ravikola02/egoumi/README.md

# EgoUMI: UMI pinch gripper + ArUco head-camera tracking

A non-powered, UMI-style handheld gripper that you close with a thumb + index pinch, tracked with ArUco markers
from an egocentric **head** camera, so that human demonstrations can become robot-learning datasets.

It builds on my [**h2r_collection**](https://github.com/ravikola02/h2r_collection) pipeline (egocentric head video →
HaWoR hand pose + head SLAM → LeRobot dataset). The goal is a `--source gripper` mode there that replaces the
HaWoR hand pose with the gripper pose from the markers and keeps HaWoR's head-camera SLAM
([plan](docs/h2r_gripper_plan.md)).

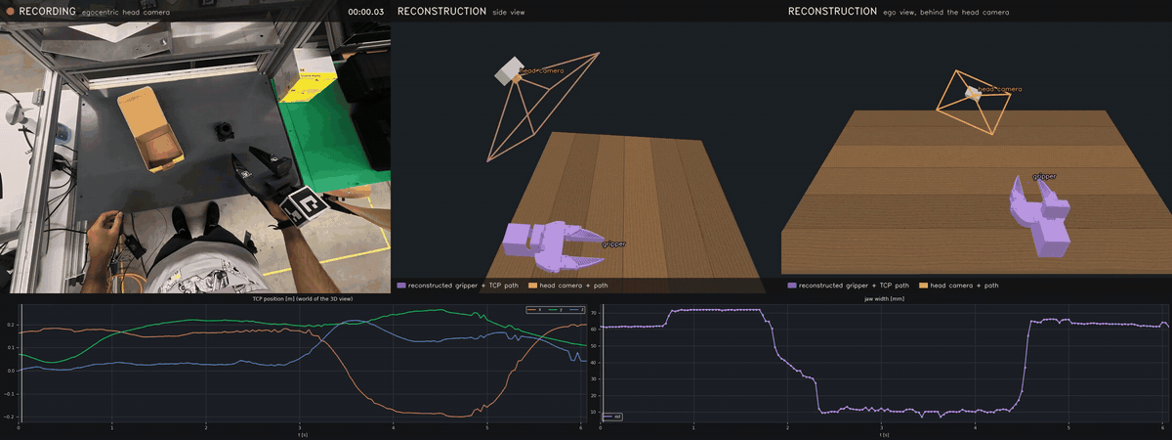
[picture p1: assets/preview_real.gif]
Real capture: egocentric head recording, side view and ego view of the reconstructed gripper and head camera


*Real capture, pick-and-place episode ([mp4](assets/preview_real.mp4)). **Left, RECORDING:** the egocentric head
camera (DJI Osmo Nano, 4:3). **Middle, side view / right, ego view (chase camera behind the head):** the gripper pose
from the ArUco markers (purple, with its TCP path) and the head camera from masked DROID-SLAM (orange, with its path).
Bottom: gripper TCP position (x, y, z) and the jaw width from
the gripper camera. No ground truth here; the 3D views are levelled with the gripper's own up axis and the table plane
is placed approximately (display only).*

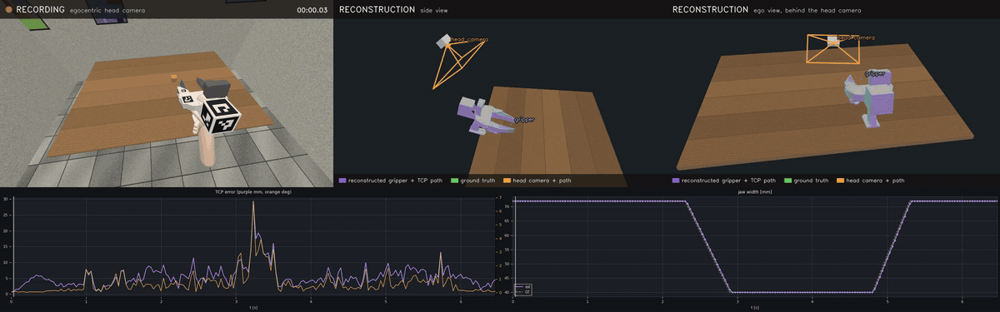
[picture p2: assets/preview_pick_place.gif]
Simulated capture: head recording, side view and ego view with ground truth, TCP error and jaw width


*Simulated pick-and-place through the same pipeline ([mp4](assets/preview_pick_place.mp4)): a rendered 3-camera
capture, ArUco pose from the head camera, head motion from masked DROID-SLAM, jaw width from the gripper camera.
Estimate in purple, ground truth in green. TCP error median 5.0 mm / p90 8.9 mm (SLAM included), jaw width within
0.9 mm. Debug style, which overlays the estimate on the frame with per-tag detail:
[wrist-roll episode](assets/preview_roll.mp4) (4.4 / 7.2 mm).
Made with `scripts/episode_preview.py` + `scripts/preview_gripper.py --style presentation --ego`.*

## What's here
| Part | Status |
|---|---|
| `cad/`: gripper derived from the [Stanford UMI](https://umi-gripper.github.io/) CAD; pistol grip kept, trigger replaced by a thumb ring and an index ring on the finger holders; mirrors removed to make room for tags | CAD done and collision-checked, print files for a Bambu H2D in `cad/out_v3` ([print notes](docs/PRINT_NOTES.md)); printed and used for real captures |
| `sim/`: synthetic head-camera episodes (textured CAD, ArUco stickers, hand stand-in, wood-grain table, object, head bob, tremor, blur, noise) in HaWoR's frame layout, with ground truth | working |
| `umi_pipe/` + `scripts/gripper_pose.py`: subpixel ArUco → multi-tag PnP (SQPNP + LM, outlier rejection, single-tag disambiguation) → joint body + jaw refinement → jaw width → world TCP pose | working in sim and on real captures (body pose found in every frame of the real episode above, 2–3 px reprojection most of the time) |
| `scripts/preview_gripper.py` (+ `scripts/episode_preview.py` for a collection episode): the previews above, the gripper counterpart of HaWoR's MANO cam/world visualisation; side view, `--ego` chase view; runs on real episodes without ground truth | working |
| `collection/`: 3-camera capture (head + 2 gripper/wrist cams) → audio sync → browser tagger → frame-exact clips → LeRobot v3.0 / v2.1, the h2r_collection flow without HaWoR ([details](collection/README.md)) | working: tested on the h2r_collection Sample session, a rendered capture and a real gripper capture (11 pick-and-place episodes; wrist offset found from audio at confidence 103; no left wrist camera) |
| Trajectories in the dataset: `--state-source aruco` reconstructs the gripper TCP from the head clips (14-d h2r_collection layout); with sim ground truth the same dataset also gets `observation.state_gt` / `action_gt` | working in sim and on real captures: gripper value from the gripper (wrist) camera; causal EMA α 0.18 on the predicted pose, position and orientation (chosen by the h2r delta-noise criterion, `sim/ema_sweep.py`); head-camera motion from masked DROID-SLAM with Metric3D scale. Real capture: the mount-based jaw fit needs a calibrated gripper-camera mount and lens, so the gripper value there comes from `scripts/gripper_minmax.py` (jaw-tag image position normalised between the most open and most closed seen; a full open/close at the start of each session will set the range) |
| `sim/render_capture.py`: rendered raw capture (head camera, gripper GoPro, blank second wrist feed, skewed clocks, clap soundtrack) + `sim/check_capture_sync.py` (sync and cut accuracy against ground truth) | working |

## Known limitations
- No camera calibration yet: the Osmo Nano intrinsics are the nominal 600 px pinhole (no lens distortion), so real
  poses carry an unmeasured bias, larger near the image edges.
- The gripper-camera mount is nominal; on real captures the gripper value is the min/max-normalised jaw signal
  (`scripts/gripper_minmax.py`), monotonic but not linear in millimetres. Open and close fully at the start of each
  session to set its range.
- The dataset world is the first head-camera frame (as h2r_collection), not gravity-aligned.

## Recording
Cameras are DJI Osmo Nanos, as in h2r_collection (head + one on the gripper). Settings, mounts and the per-session
checklist (4K head, stabilization off, landscape locked, a clap at the start of every take):
[docs/recording_setup_osmo_nano.md](docs/recording_setup_osmo_nano.md).

## Printing the markers
[`assets/print/egoumi_aruco_markers.pdf`](assets/print/egoumi_aruco_markers.pdf) holds all eight markers the pipeline
uses (DICT_4X4_50, IDs 0–7) at exact size on one A4 page, with a back page that, printed double-sided, puts each
marker's placement (part, face and which edge is the top) directly behind it. Print at **100 % / Actual size**,
**double-sided, flip on the long edge**, check the 100 mm bar, and cut along the dashed lines without trimming the
white border. It is generated from `configs/gripper_markers.yaml`:
`python3 scripts/make_marker_sheet.py` (add `--flip short` if your printer flips on the short edge).

| IDs | Where | Marker | Cut size |
|---|---|---|---|
| 0–3 | cube: rear, top, left, right faces | 60 mm | 70 mm (whole face) |
| 4, 5 | top cover: left and right wings (where the mirrors were) | 35 mm | 45 mm |
| 6, 7 | finger holders: top pads (left = thumb, right = index) | 18 mm | 20 mm |

## Quick start: capture → LeRobot dataset
```bash
python3 collection/run_pipeline.py --session <session>   # data/raw/<session>/{top_cam,left_w_cam,right_w_cam}/
```
See [collection/README.md](collection/README.md).

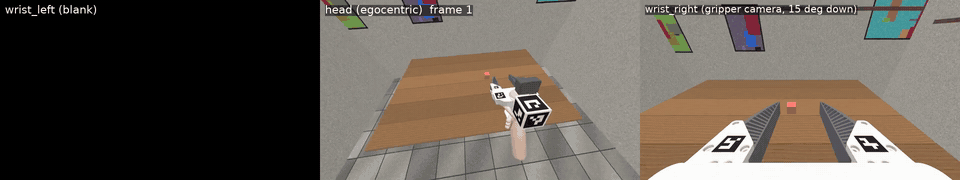
[picture p3: assets/dataset_sim_capture.gif]
LeRobot dataset built from a rendered capture: blank left wrist, head camera, gripper GoPro


*A LeRobot v3.0 dataset made by the pipeline from a rendered capture ([mp4](assets/dataset_sim_capture.mp4)): blank
left wrist feed | head camera | GoPro on the gripper. The three recordings started at different times with skewed
clocks; the audio sync recovered the offsets exactly and every cut is frame-exact against ground truth.*

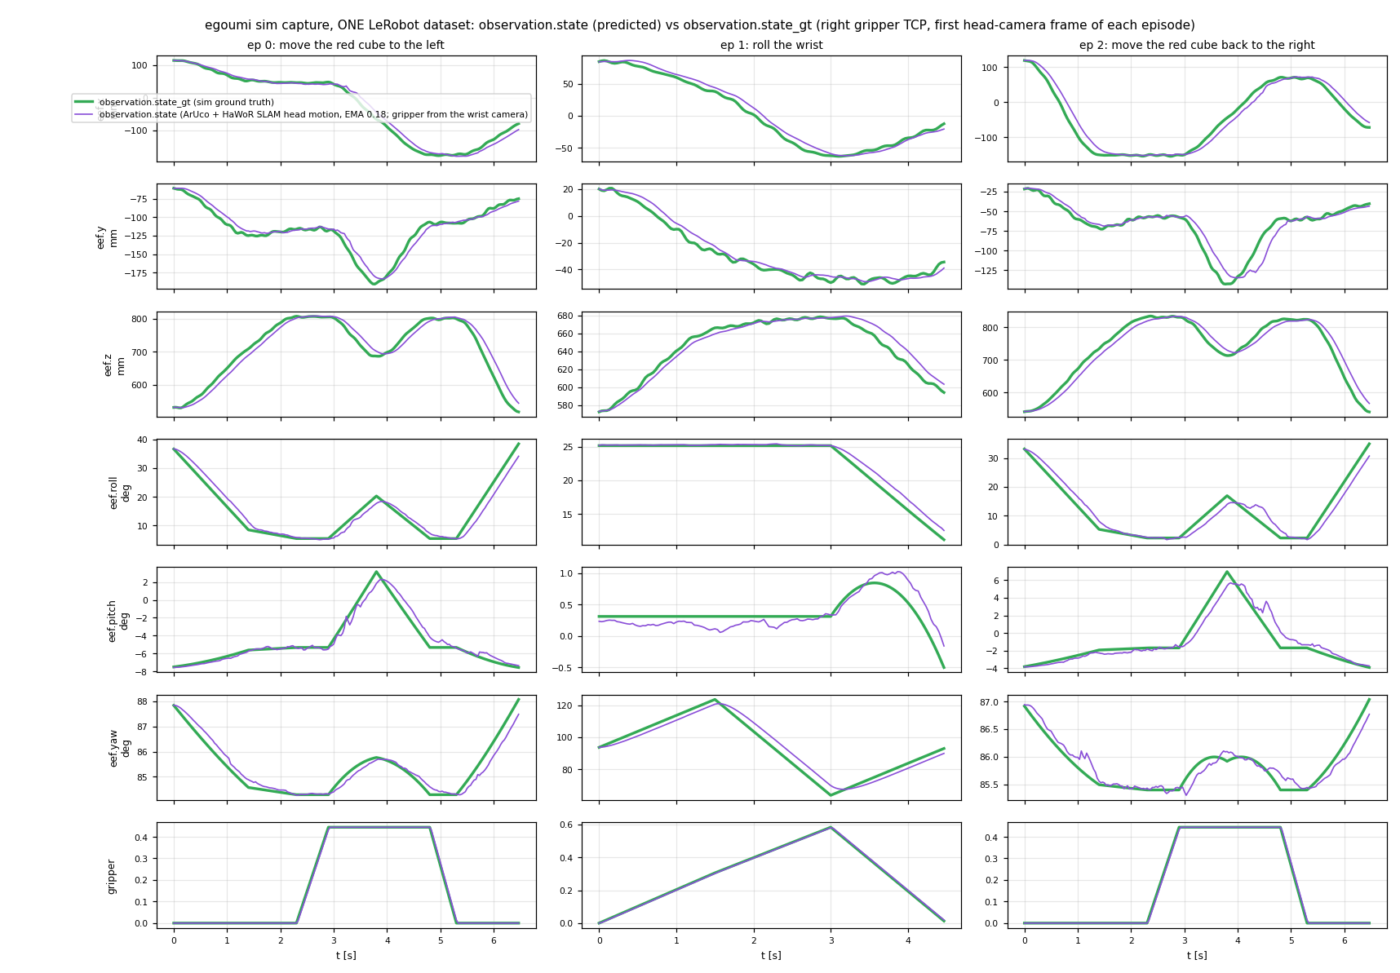
[picture p4: assets/dataset_trajectories.png]
observation.state (ArUco pipeline) vs observation.state_gt (ground truth) from that dataset


*The same dataset's trajectory columns: `observation.state` reconstructed by the full pipeline (purple) against the
raw `observation.state_gt` (green), right gripper TCP in each episode's first head-camera frame. The gripper pose
comes from the ArUco markers and the head-camera motion from masked DROID-SLAM (Metric3D scale); the
gripper value comes from the wrist camera (within about 1 mm of jaw width). Before the EMA the TCP error is
3.3–5.3 mm median. The pose carries a causal EMA (α 0.18 on position and on orientation, 152 ms lag), which brings
the one-step delta noise to the G1 robot's level; the lag is what separates the purple and green position curves
(`--ema-pos 1` turns it off).*

## Quick start (simulation)
Runs in a Python env with `pyrender`, `trimesh`, `opencv-python` (≥ 4.7, ArUco), `scipy`, `pyyaml` and
`matplotlib` (the HaWoR env from h2r_collection has all of them), with headless EGL rendering and `ffmpeg`.
```bash
sim/run_sim_test.sh pick_place                                            # render -> pose -> preview
MARKERS=configs/gripper_markers_jawflags.yaml sim/run_sim_test.sh pick_place_jawflags
sim/run_sim_test.sh roll --preset roll --seed 1
sim/run_sim_test.sh blur_table --blur 5 -- --cam-source table              # args after -- go to gripper_pose.py
# output: sim/episodes/<name>/preview/{gripper_preview.mp4,metrics.json,timeline.png}
```
Set `PY=/path/to/python` if your interpreter is not the HaWoR conda env. `sim/assets/meshes` is checked in;
`sim/export_meshes.py` regenerates it from the STEP file (needs CadQuery).

## Sim results
Egocentric head camera (behind and above the user's hands) with the h2r_collection DJI Osmo Nano intrinsics at
1080p (600 px focal); gripper and markers as in the CAD. A 4K head (recommended) doubles the marker size in pixels.

| Episode | TCP error median / p90 / max | Jaw width seen by the head camera |
|---|---|---|
| pick-and-place | 2.7 / 6.1 / 15.0 mm | 10 % of frames (width error median 0.20, max 0.66 mm) |
| wrist roll | 1.6 / 2.6 / 5.1 mm | 8 % (median 0.23, max 0.48 mm) |

Jaw width comes from the **gripper (wrist) camera**, as in UMI. In the render it sits at the GoPro lens, pitched
down 15° so both jaw tags stay in its pinhole frame over the full travel; it sees both tags at every travel.

What the sim showed so far (details in [sim/README.md](sim/README.md)):
- From the head camera the GoPro and the cube often block the holder-top jaw tags; the wrist camera always sees
  them. An earlier claim here, that they were never visible, came from two renderer bugs (sheared jaw-tag
  textures; stickers lit only by ambient light), both fixed.
- Frames where only one body tag is visible cause most of the head-camera pose error: the TCP is about 29 cm from
  the cube tags.
- Head-camera motion comes from masked DROID-SLAM with Metric3D scale, with the
  gripper and hand masked at their ArUco pose. On the rendered capture it tracks the head within 2–4 mm and
  0.03–0.05° (median); Metric3D's scale is 8–22 % off, the largest remaining term. In a plain-coloured room it
  failed (scale 3.9× off, 13 mm/frame jitter): it needs scene texture, which real rooms have.
- There is no table marker: like h2r_collection, the world frame is each episode's first head-camera frame.

Not modelled yet: lens distortion, rolling shutter, glare. The TCP point is an estimate from the CAD.

## Layout
```
cad/            CadQuery build scripts (v1 → v3), Stanford UMI input STEP, v3 print files, renders
collection/     capture → LeRobot pipeline (sync, tagger, converter)
configs/        marker layouts (body frame = CAD assembly frame, metres), sim camera
docs/           pipeline plan for h2r_collection, print notes
sim/            episode + raw-capture renderers, sync/cut checker, mesh export, one-command test runner
umi_pipe/       shared model / rendering / pose-estimation code
scripts/        gripper_pose.py (pipeline), preview_gripper.py (preview)
assets/         README media
```

## Credits and licence
- The gripper design is adapted from Stanford's [Universal Manipulation Interface (UMI)](https://umi-gripper.github.io/)
  (Chi et al., RSS 2024): its CAD, mechanism and soft fingers are kept, the trigger is replaced by a thumb + index
  pinch, and the side mirrors are removed to make room for ArUco markers. The files in `cad/input/` are their
  design exported from Onshape; their terms apply to that design.
- Data pipeline: [h2r_collection](https://github.com/ravikola02/h2r_collection); `collection/` vendors its sync,
  tagger and dataset writers.
- Head-camera SLAM: the masked DROID-SLAM + Metric3D-scale approach comes from
  [HaWoR](https://github.com/ThunderVVV/HaWoR) (CC BY-NC-ND), and `collection/head_slam.py` runs HaWoR's own SLAM
  wrapper (`hawor_slam`, unmodified) from a local HaWoR checkout; HaWoR is not redistributed here.
  [DROID-SLAM](https://github.com/princeton-vl/DROID-SLAM) (BSD-3), [Metric3D](https://github.com/YvanYin/Metric3D) (BSD-2).
- The code in this repository is MIT licensed (see `LICENSE`).
