ravikola02/egoumi/assets/timeline_pick_place.png

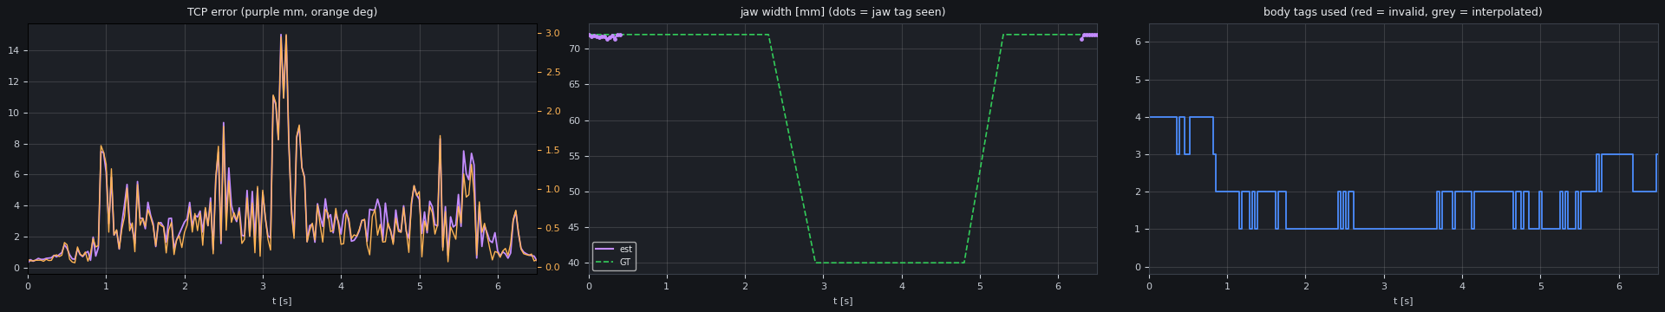
assets/timeline_pick_place.png
