ravikola02/egoumi/cad/renders/orig_full.png

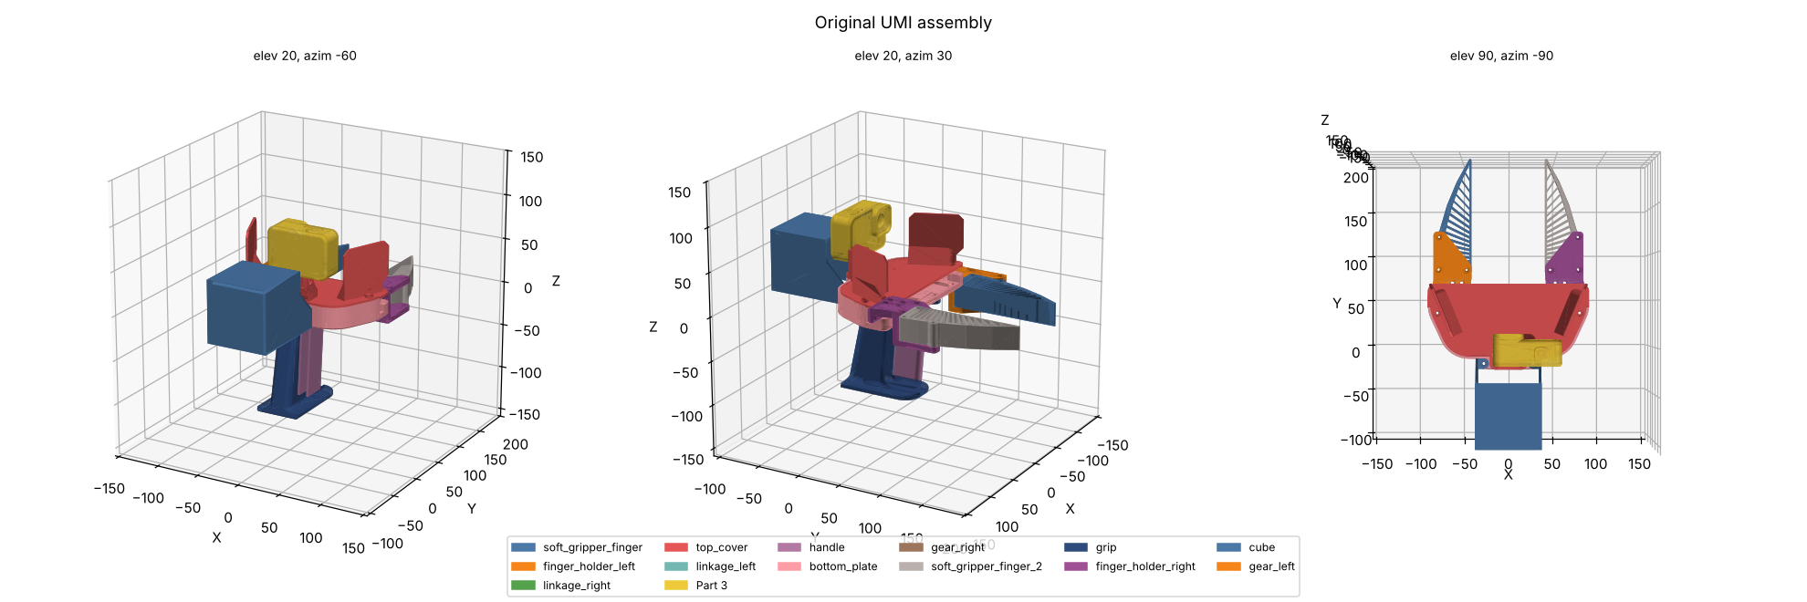
cad/renders/orig_full.png
