ravikola02/egoumi/cad/renders/orig_gears.png

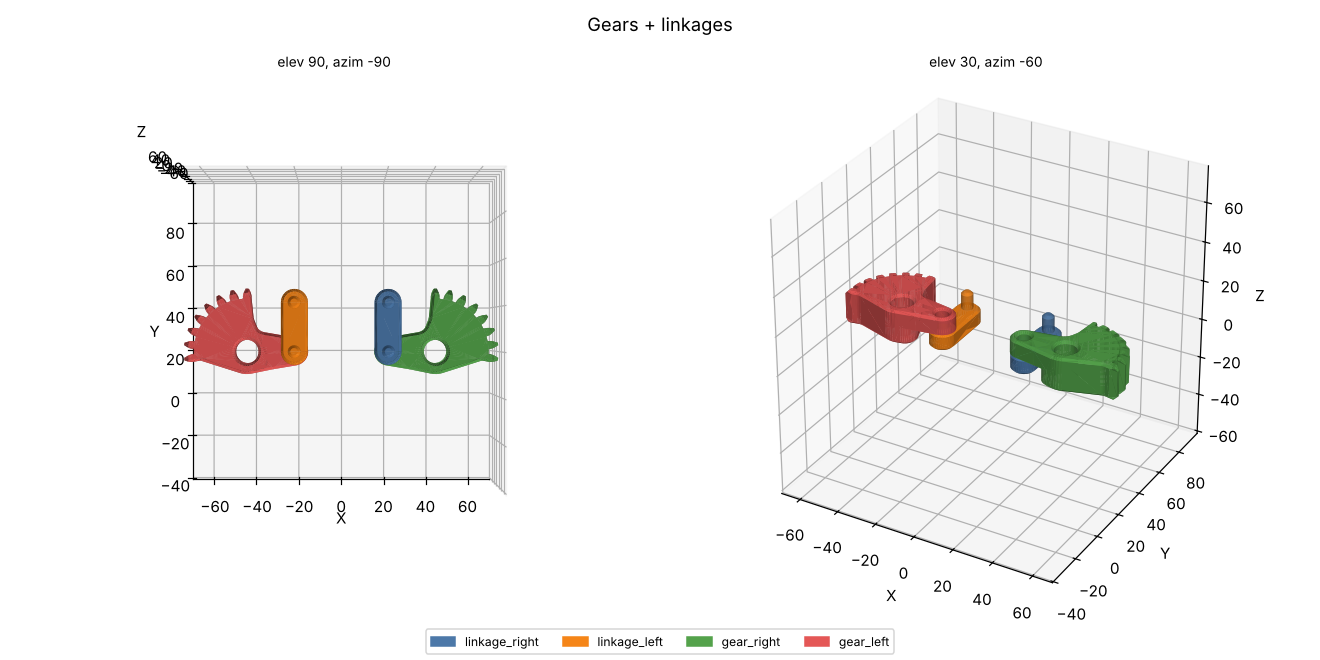
cad/renders/orig_gears.png
