ravikola02/egoumi/cad/renders/orig_handle_grip.png

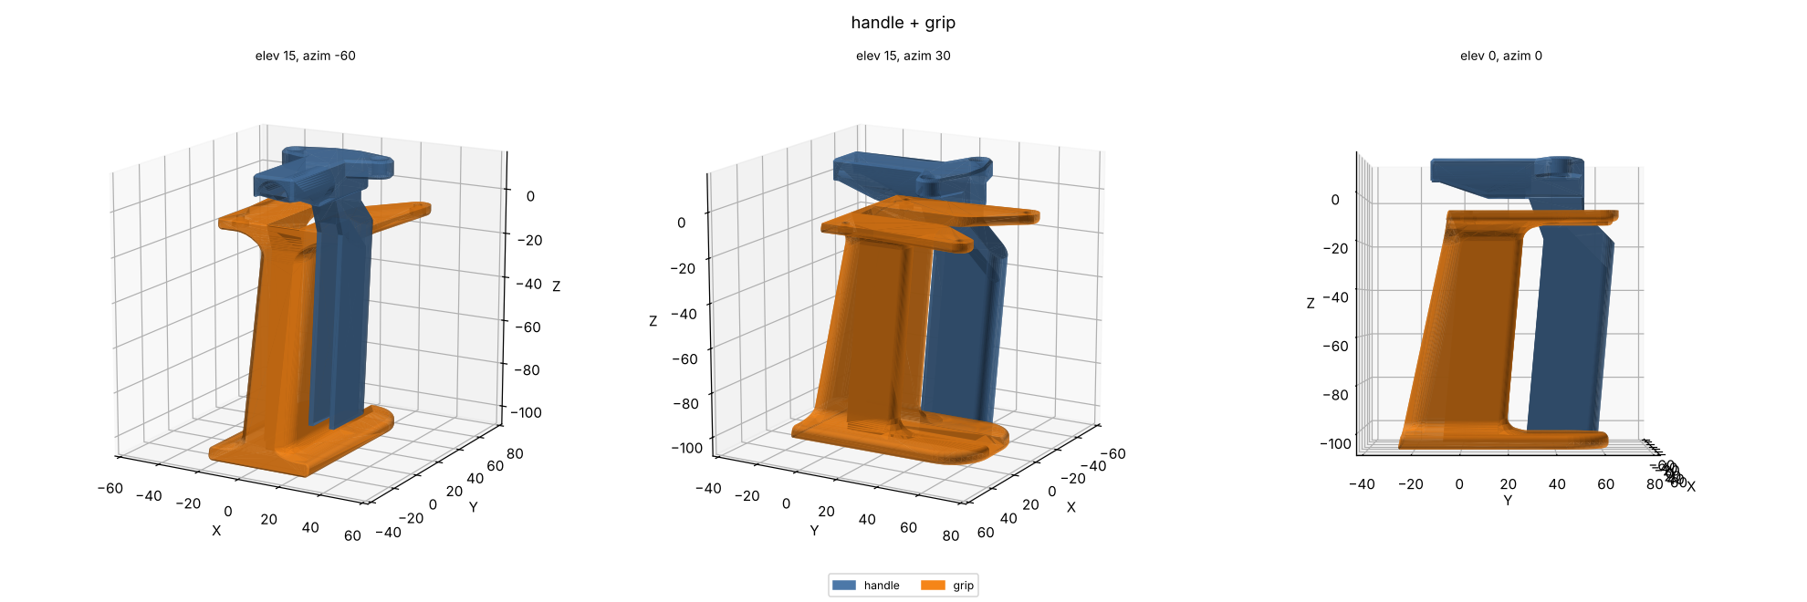
cad/renders/orig_handle_grip.png
