ravikola02/egoumi/cad/renders/orig_mech.png

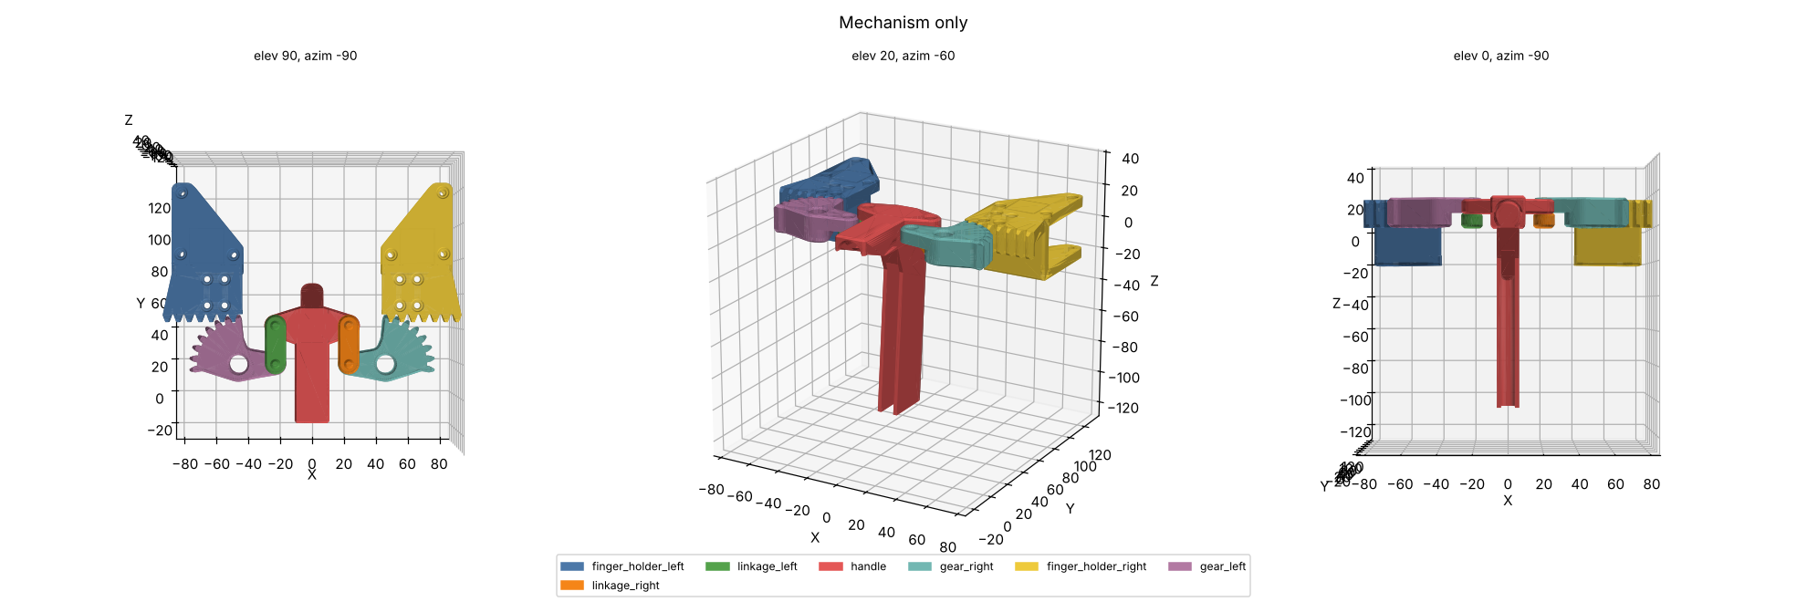
cad/renders/orig_mech.png
