ravikola02/egoumi/cad/renders/orig_section_x0.png

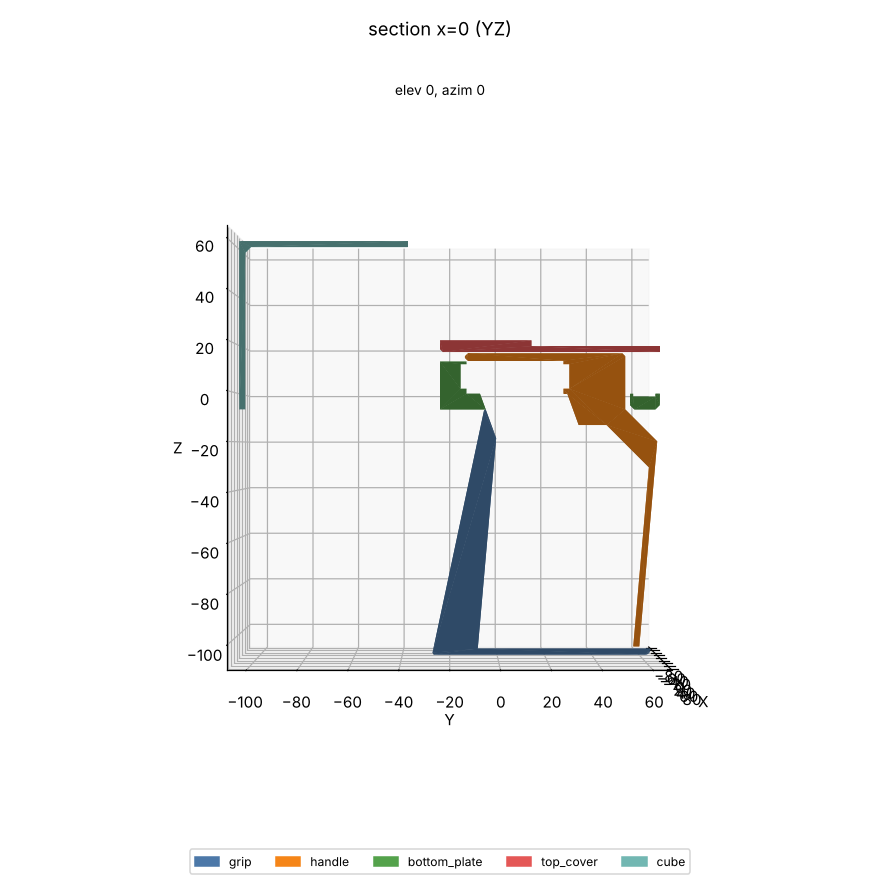
cad/renders/orig_section_x0.png
