ravikola02/egoumi/cad/renders/probe_finger_holder_left_thumb.png

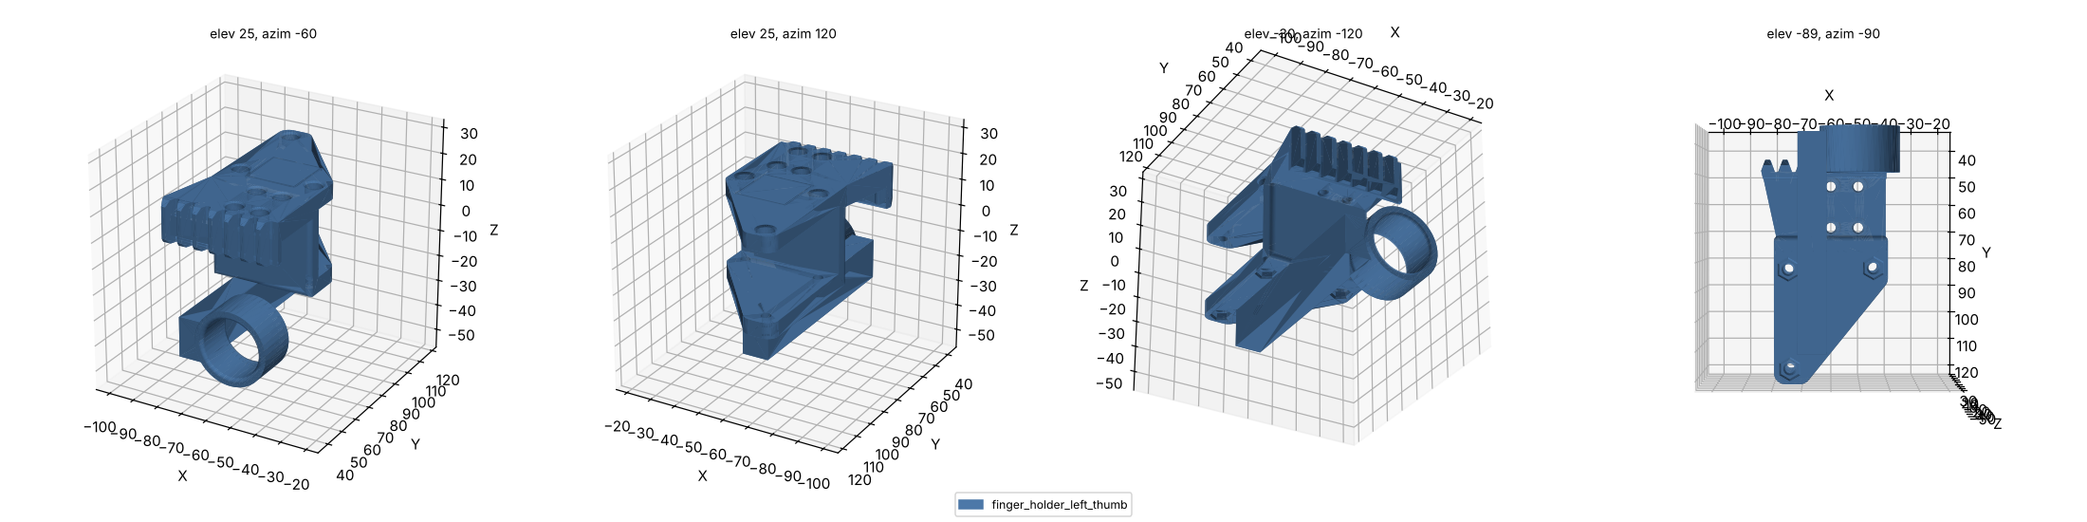
cad/renders/probe_finger_holder_left_thumb.png
