ravikola02/egoumi/cad/renders/probe_holder_bottom.png

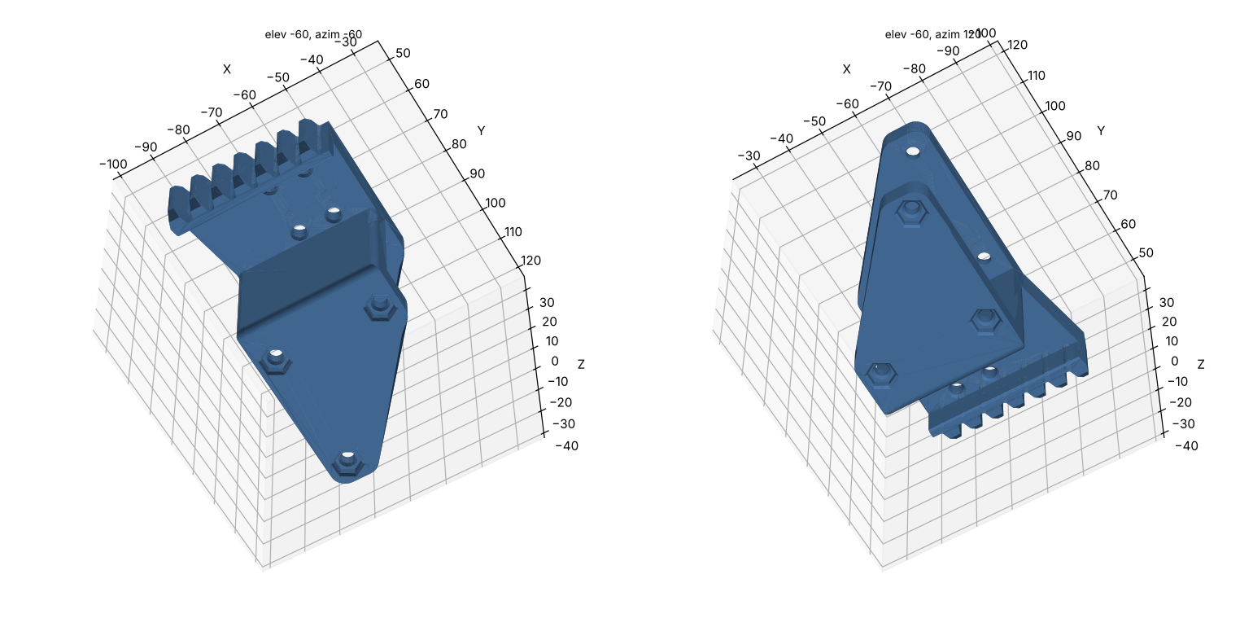
cad/renders/probe_holder_bottom.png
