ravikola02/egoumi/cad/renders/probe_holder_top.png

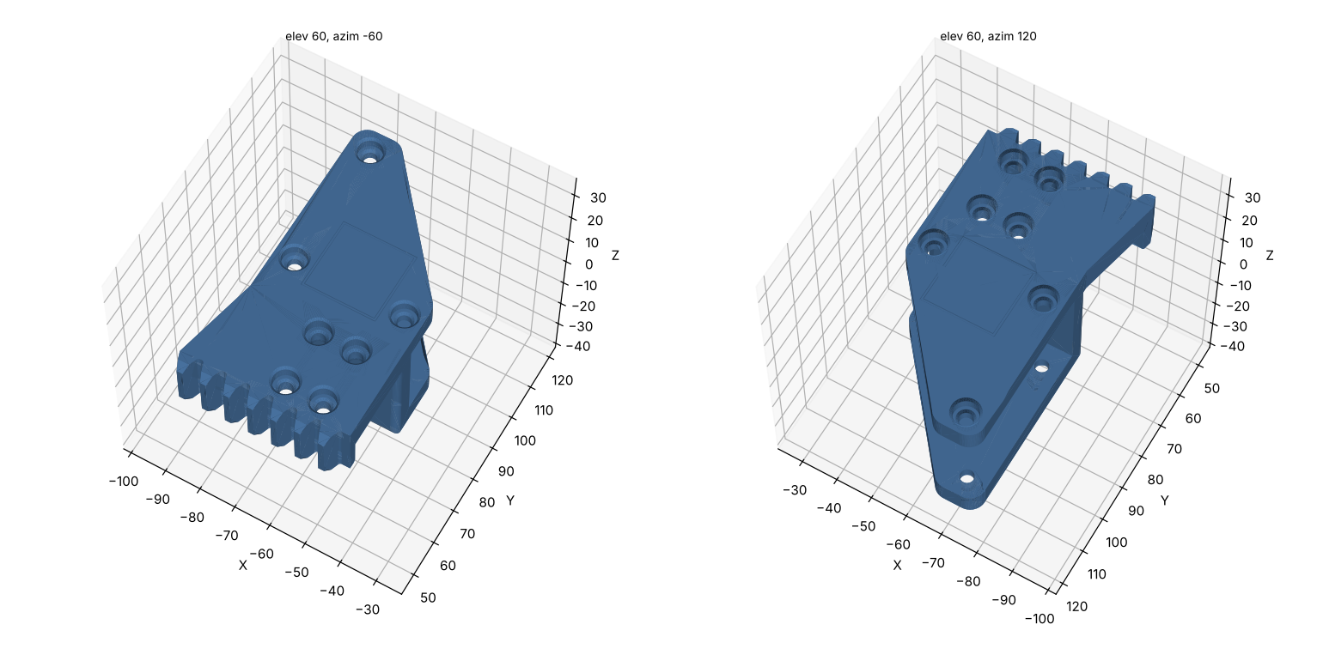
cad/renders/probe_holder_top.png
