ravikola02/egoumi/cad/renders/probe_topcover.png

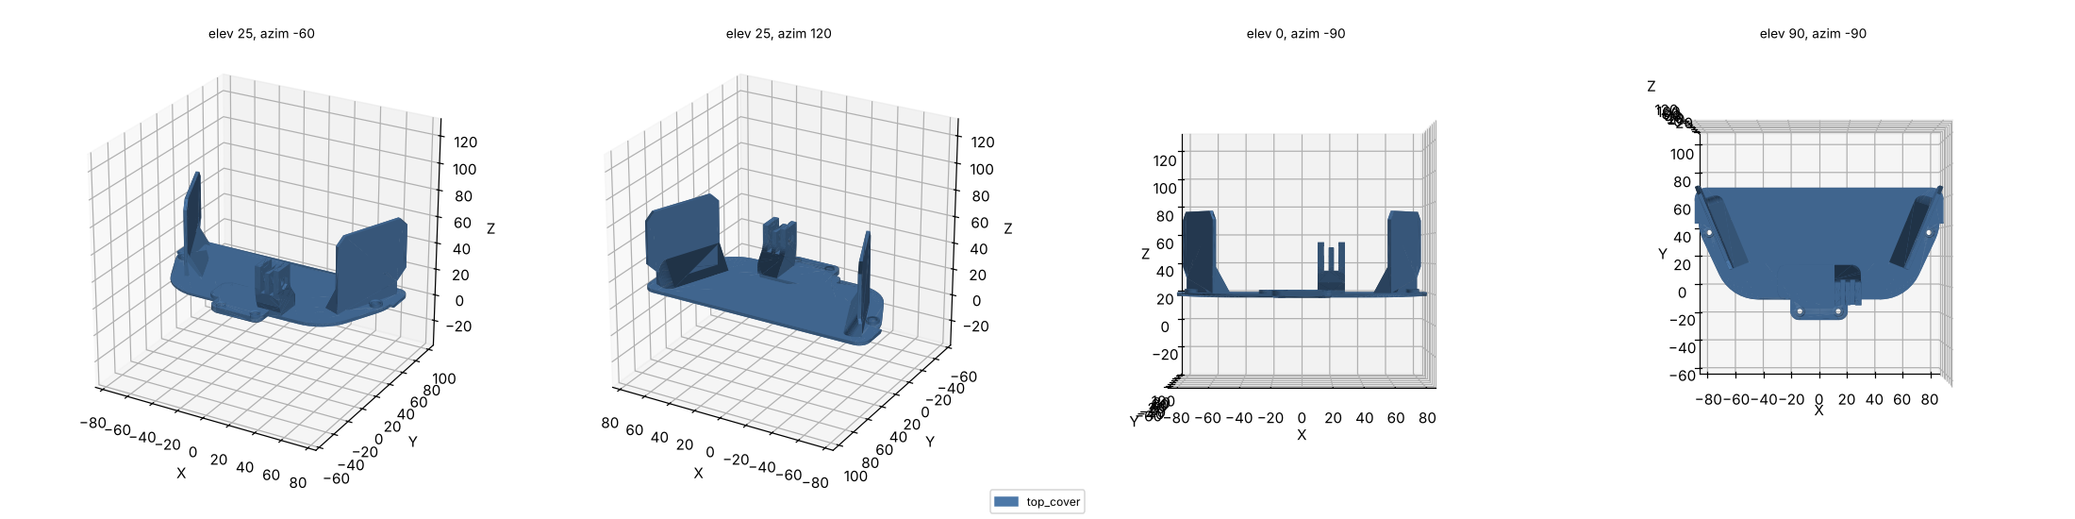
cad/renders/probe_topcover.png
