ravikola02/egoumi/cad/renders/v1_closed.png

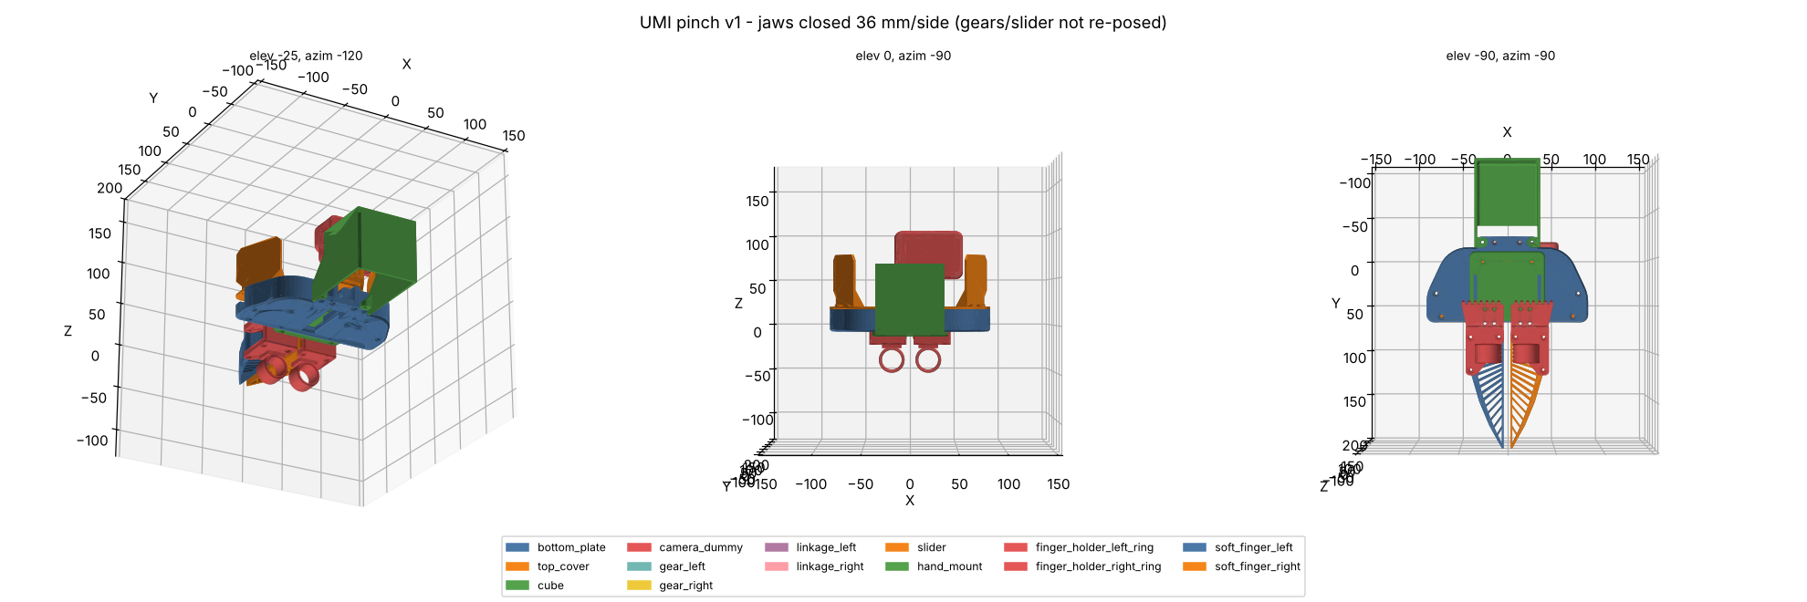
cad/renders/v1_closed.png
