ravikola02/egoumi/cad/renders/v1_newparts.png

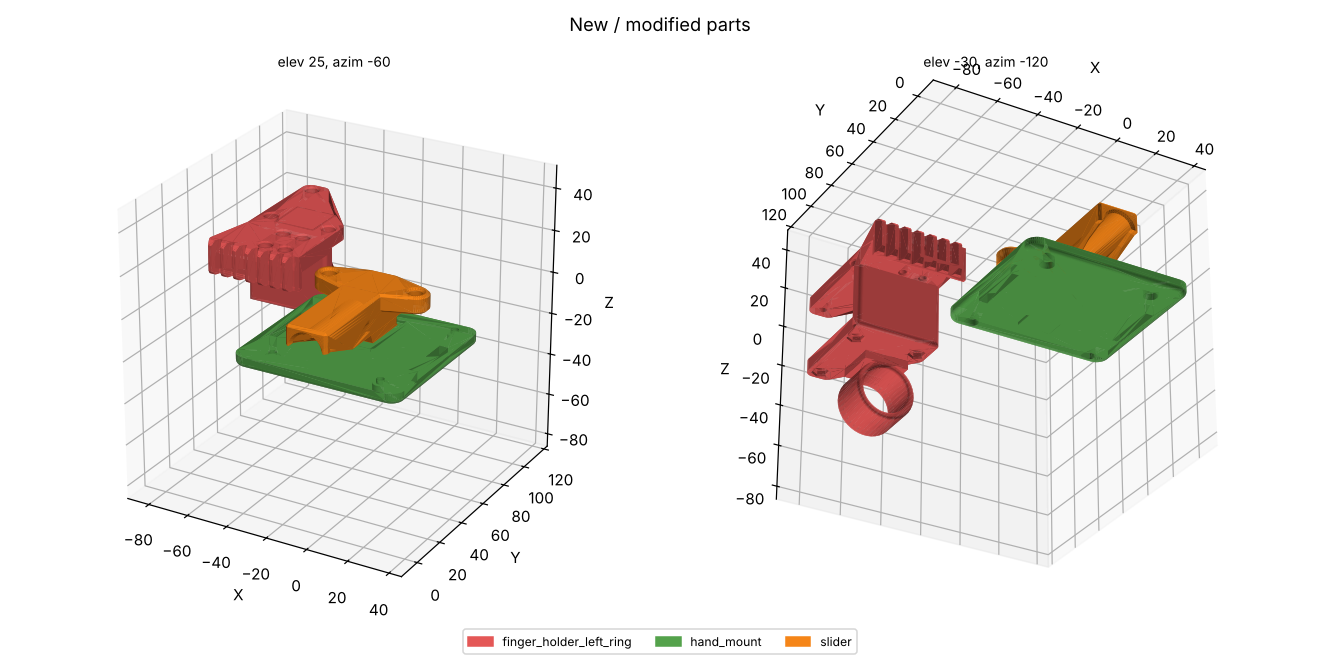
cad/renders/v1_newparts.png
