ravikola02/egoumi/cad/renders/v1_open.png

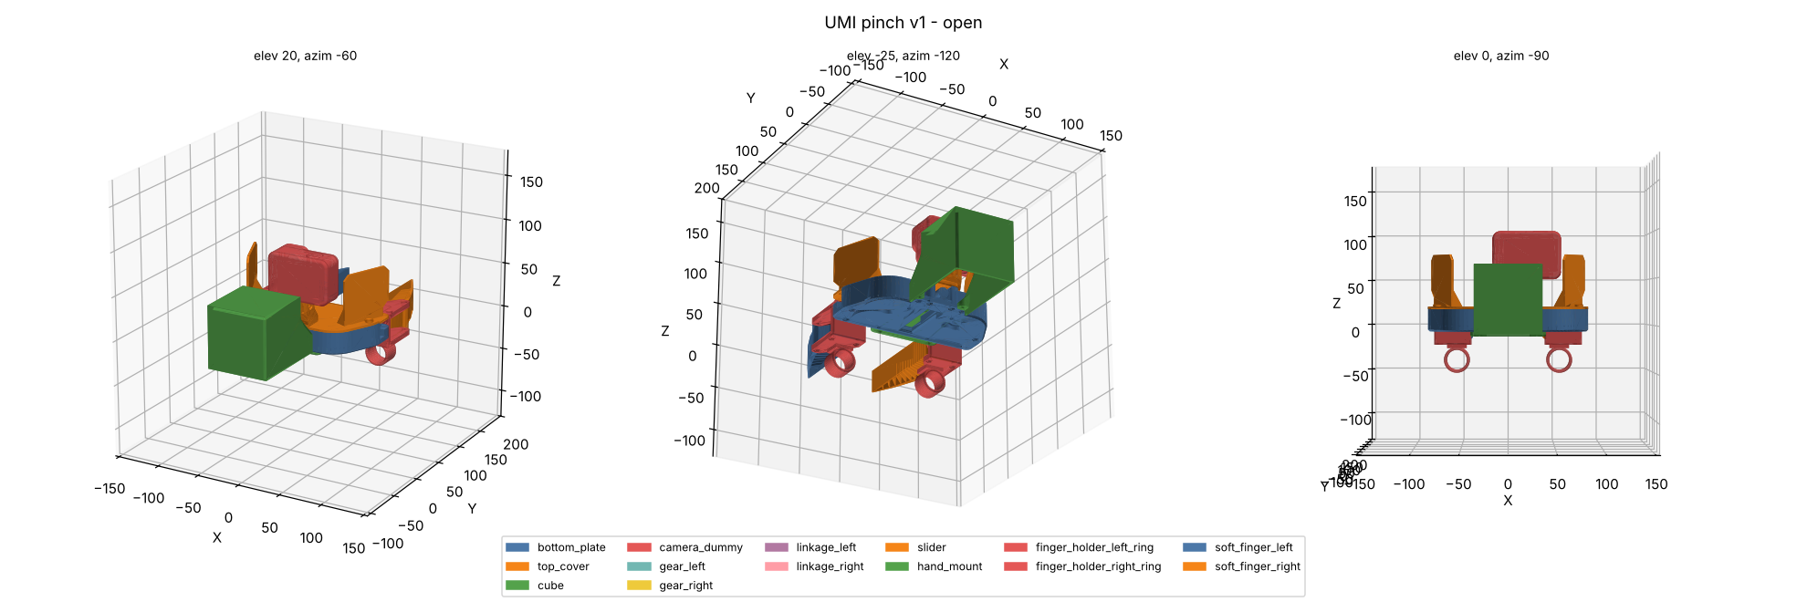
cad/renders/v1_open.png
