ravikola02/egoumi/cad/renders/v2_closed.png

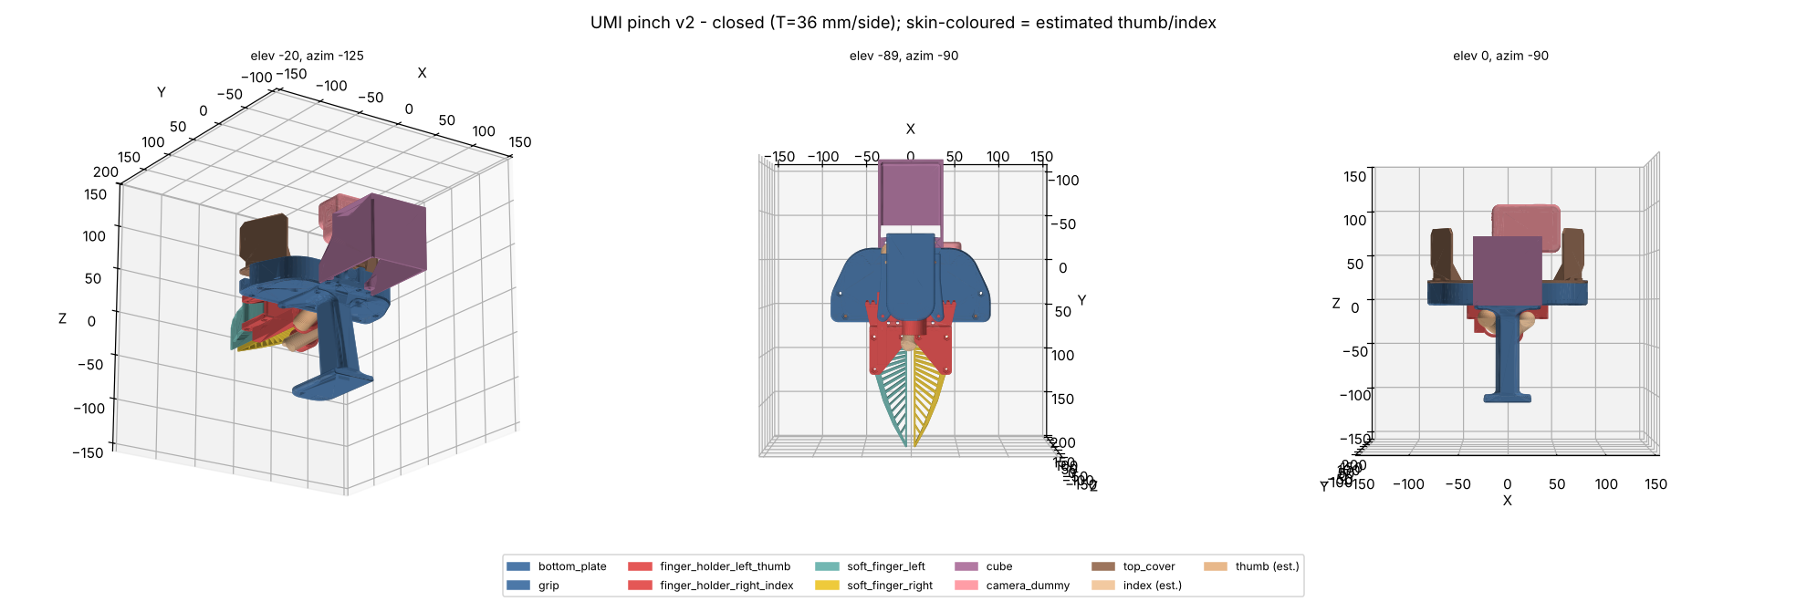
cad/renders/v2_closed.png
