ravikola02/egoumi/cad/renders/v2_rings.png

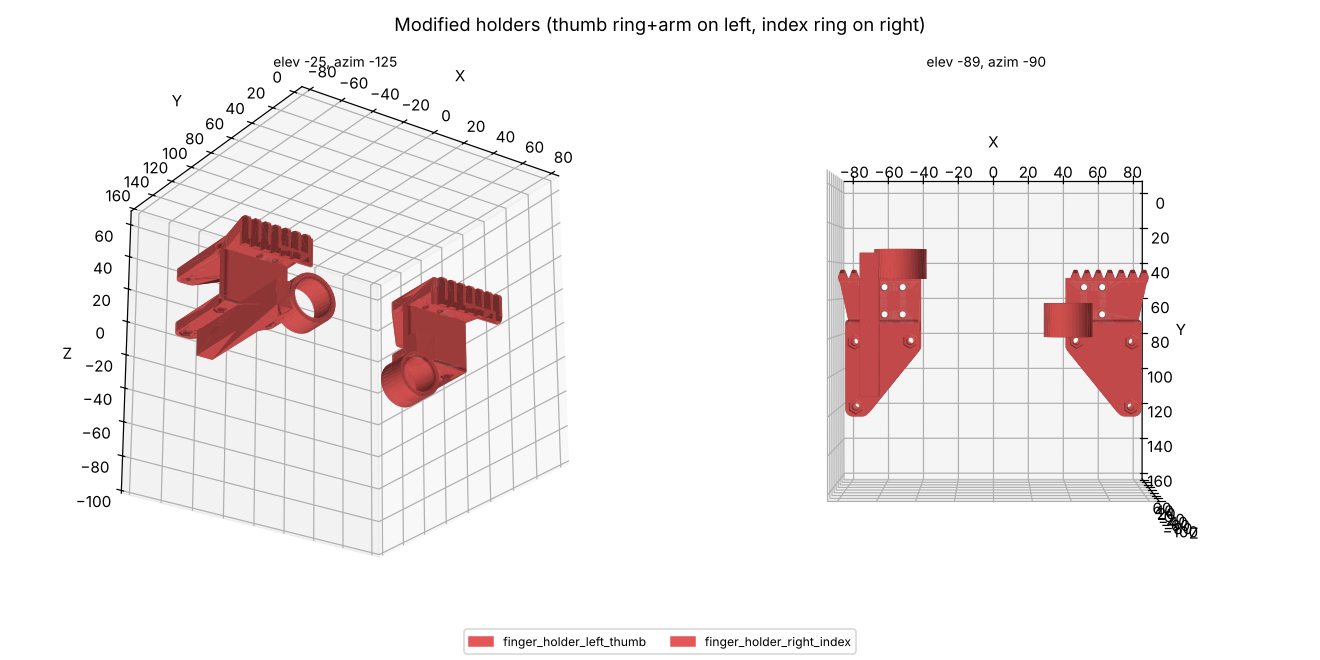
cad/renders/v2_rings.png
