ravikola02/egoumi/cad/renders/v3_cover_after.png

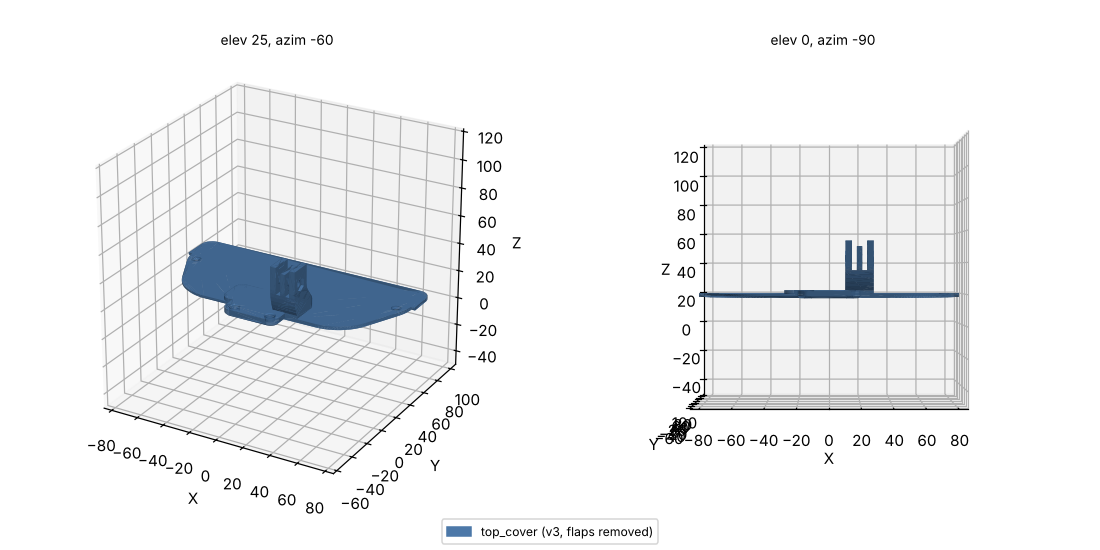
cad/renders/v3_cover_after.png
