ravikola02/egoumi/cad/renders/v3_cover_before.png

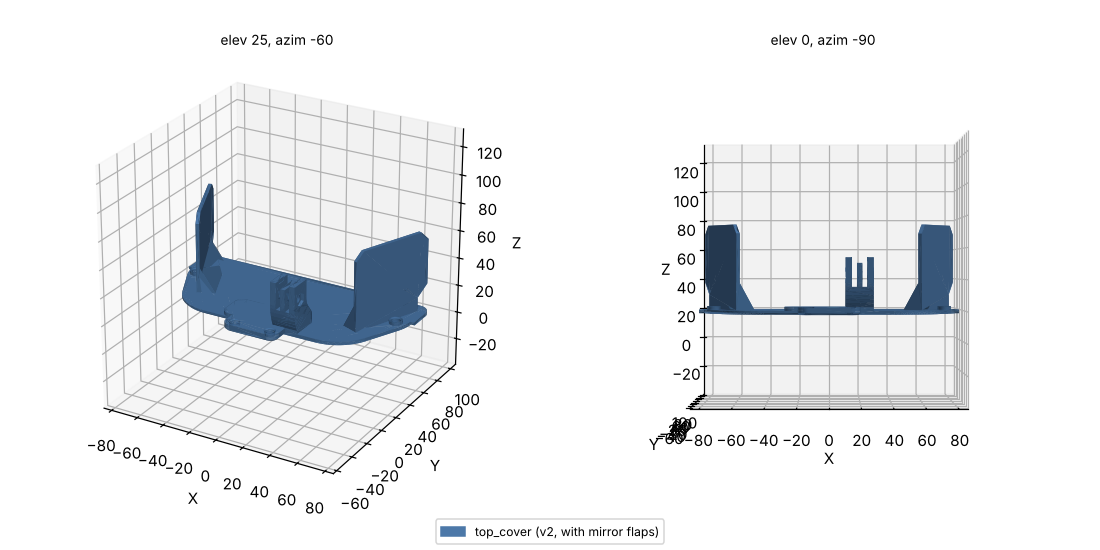
cad/renders/v3_cover_before.png
