ravikola02/egoumi/cad/renders/v4_cover.png

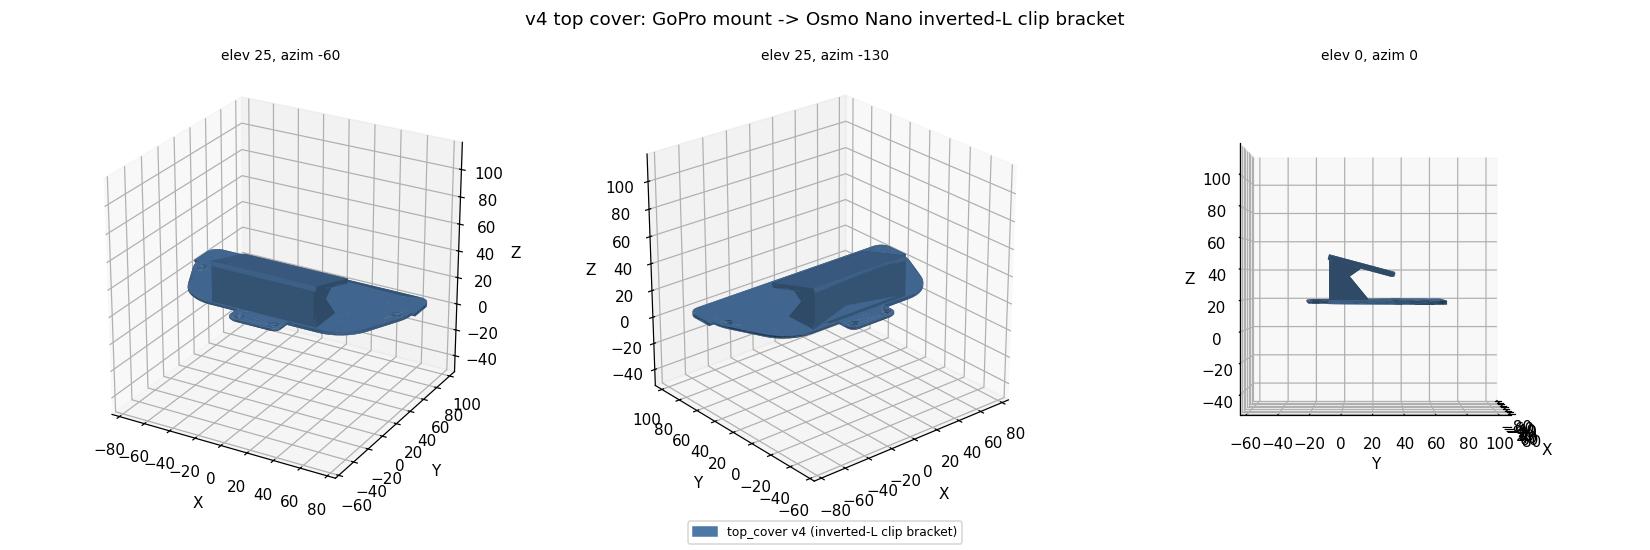
cad/renders/v4_cover.png
