ravikola02/egoumi/cad/out_v3/umi_pinch_v3_assembly.step

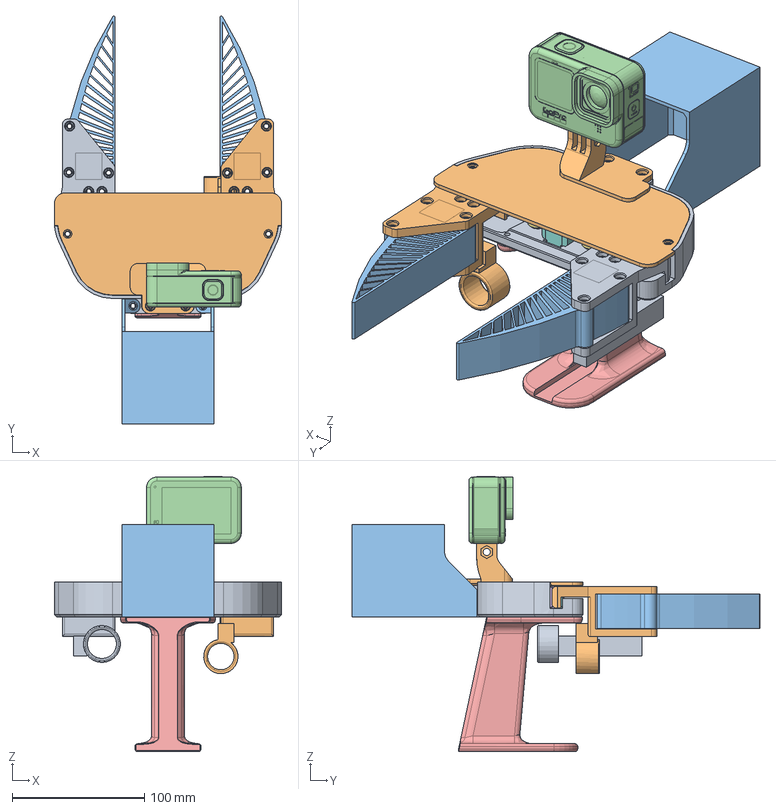
[picture p23: CAD file, 2026-10-28]
cad/out_v3/umi_pinch_v3_assembly.step
172.0 x 308.9 x 208.4 mm
bottom_plate
top_cover
camera_dummy
grip
gear_left
gear_right
linkage_left
linkage_right
slider
finger_holder_left_thumb
finger_holder_right_index
soft_finger_left
soft_finger_right
