ravikola02/egoumi/cad/input/vis_assembly.step

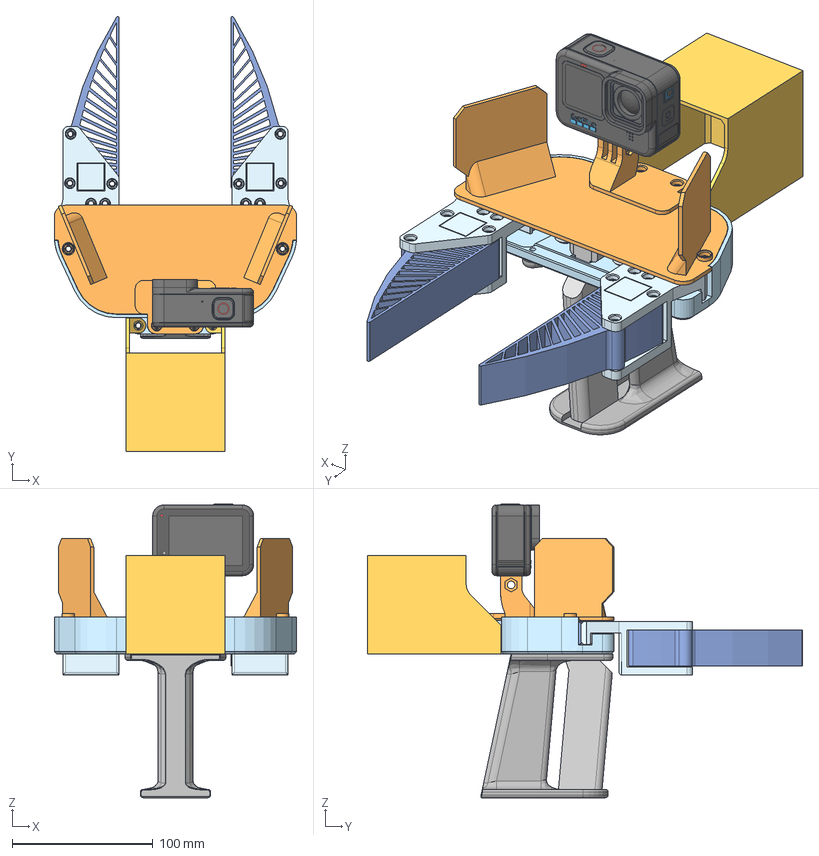
[picture p24: CAD file, 2026-10-28]
cad/input/vis_assembly.step
172.0 x 308.9 x 208.4 mm
soft_gripper_finger x 2
finger_holder_left
linkage_right
top_cover
linkage_left
handle
bottom_plate
gear_right
grip
finger_holder_right
gear_left
