ravikola02/egoumi/cad/input/soft_gripper_finger.step

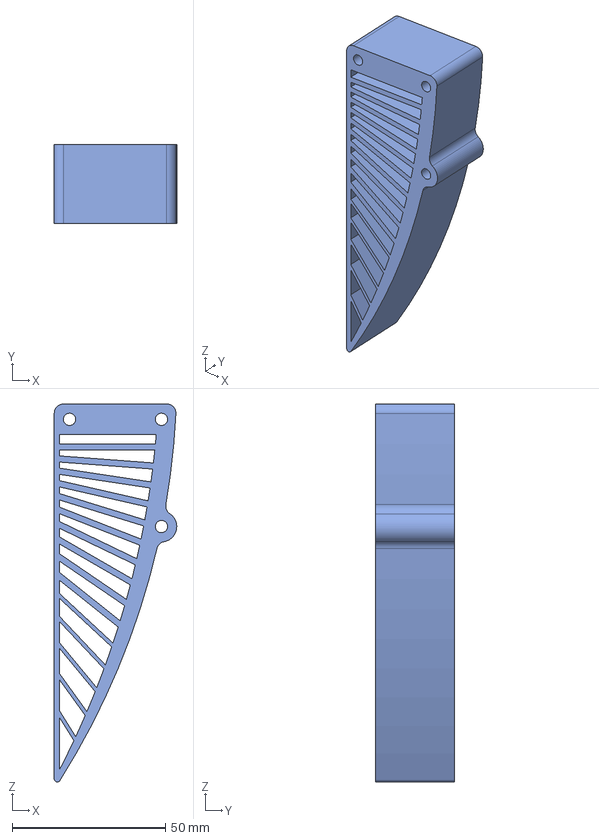
[picture p25: CAD file, 2026-10-28]
cad/input/soft_gripper_finger.step
40.0 x 25.8 x 123.4 mm
