ravikola02/egoumi/sim/assets/meshes/grip.stl

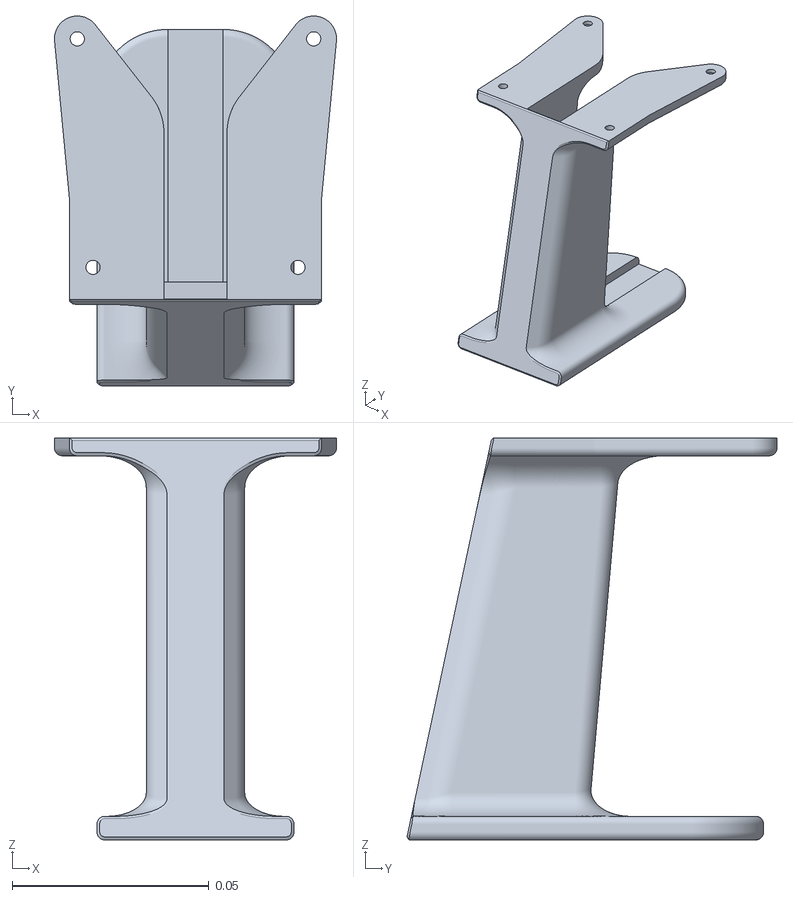
[picture p26: CAD file, 2026-10-28]
sim/assets/meshes/grip.stl
0.0716 x 0.0939 x 0.102
