ravikola02/egoumi/cad/out_v3/UMI_print2_internals_PLA.3mf

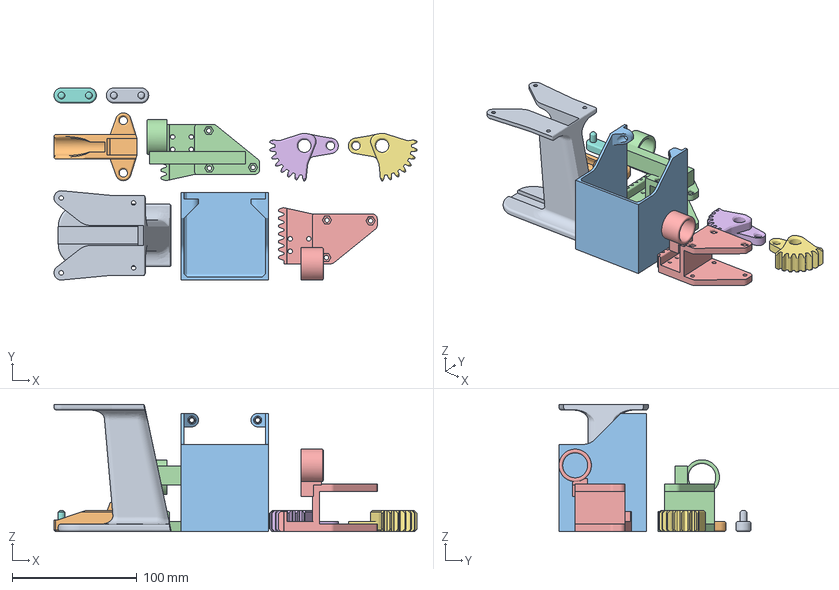
[picture p27: CAD file, 2026-10-28]
cad/out_v3/UMI_print2_internals_PLA.3mf
291.1 x 154.0 x 102.0 mm
grip
slider
finger_holder_left_thumb
finger_holder_right_index
gear_left
gear_right
linkage_left
linkage_right
