ravikola02/egoumi/sim/assets/meshes/soft_finger_right.stl

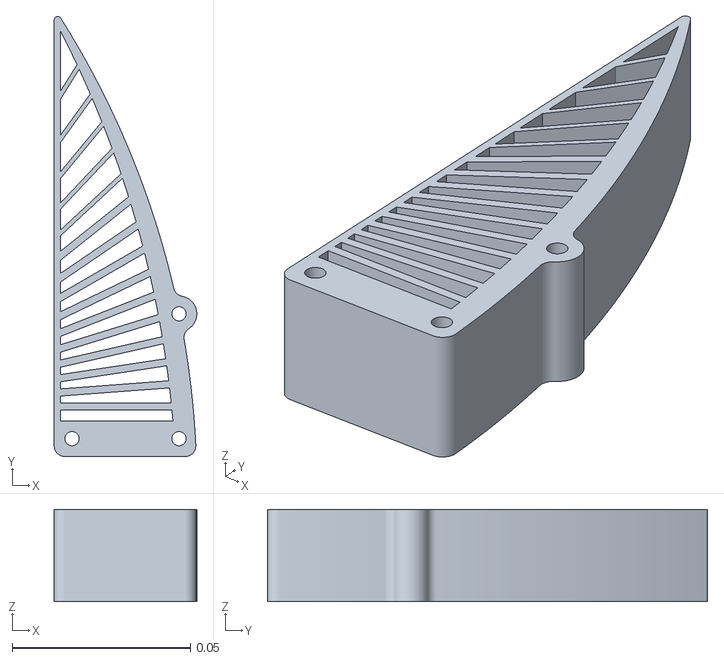
[picture p28: CAD file, 2026-10-28]
sim/assets/meshes/soft_finger_right.stl
0.04 x 0.123 x 0.0258
