ravikola02/egoumi/cad/out_v3/UMI_print1_covers_PLA.3mf

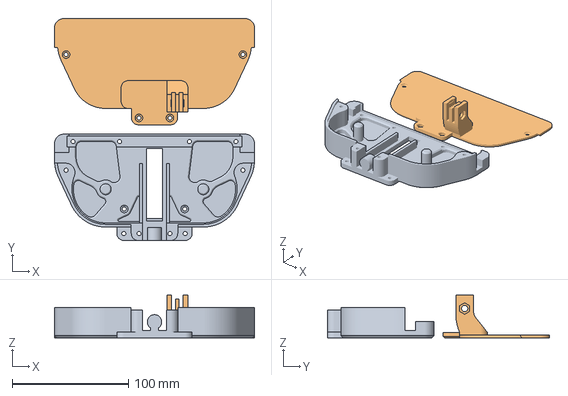
[picture p29: CAD file, 2026-10-28]
cad/out_v3/UMI_print1_covers_PLA.3mf
172.0 x 190.8 x 36.7 mm
bottom_plate
top_cover
