ravikola02/egoumi/sim/assets/meshes/camera_dummy.stl

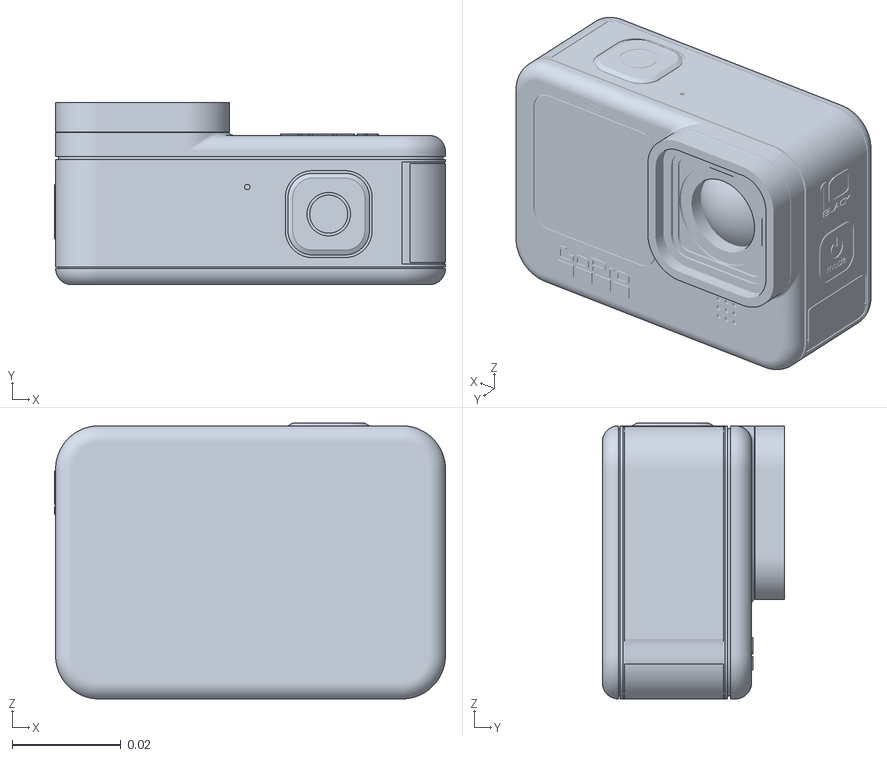
[picture p30: CAD file, 2026-10-28]
sim/assets/meshes/camera_dummy.stl
0.072 x 0.0336 x 0.0508
