ravikola02/egoumi/sim/assets/meshes/linkage_right.stl

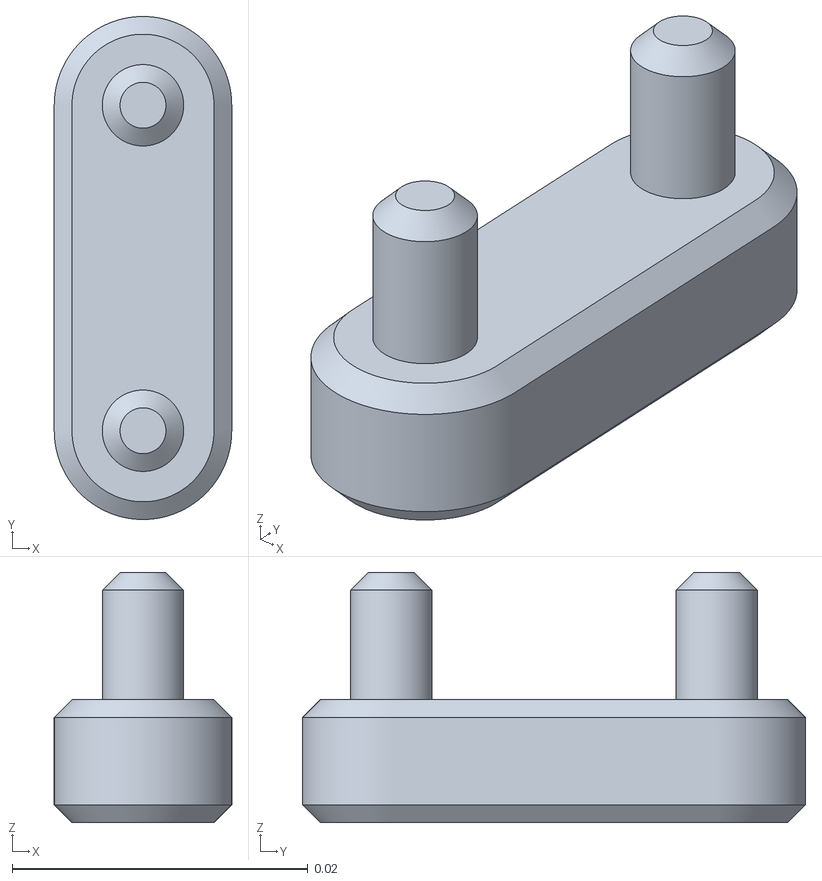
[picture p31: CAD file, 2026-10-28]
sim/assets/meshes/linkage_right.stl
0.012 x 0.034 x 0.0169
