ravikola02/egoumi/cad/out_v3/gear_left.stl

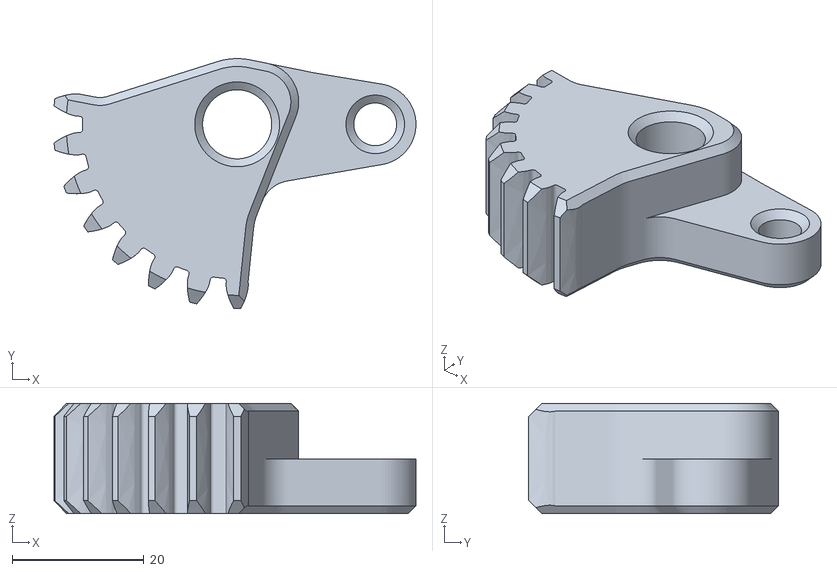
[picture p32: CAD file, 2026-10-28]
cad/out_v3/gear_left.stl
55.1 x 38.0 x 16.8
