ravikola02/egoumi/sim/assets/meshes/bottom_plate.stl

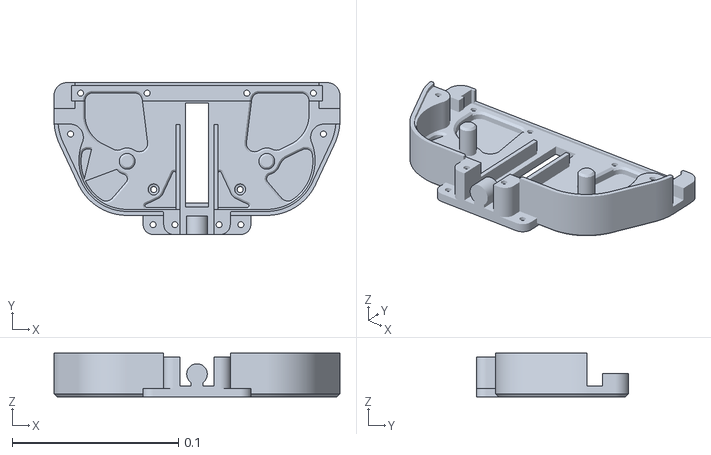
[picture p33: CAD file, 2026-10-28]
sim/assets/meshes/bottom_plate.stl
0.172 x 0.0914 x 0.0263
