ravikola02/egoumi/cad/out_v3/grip.stl

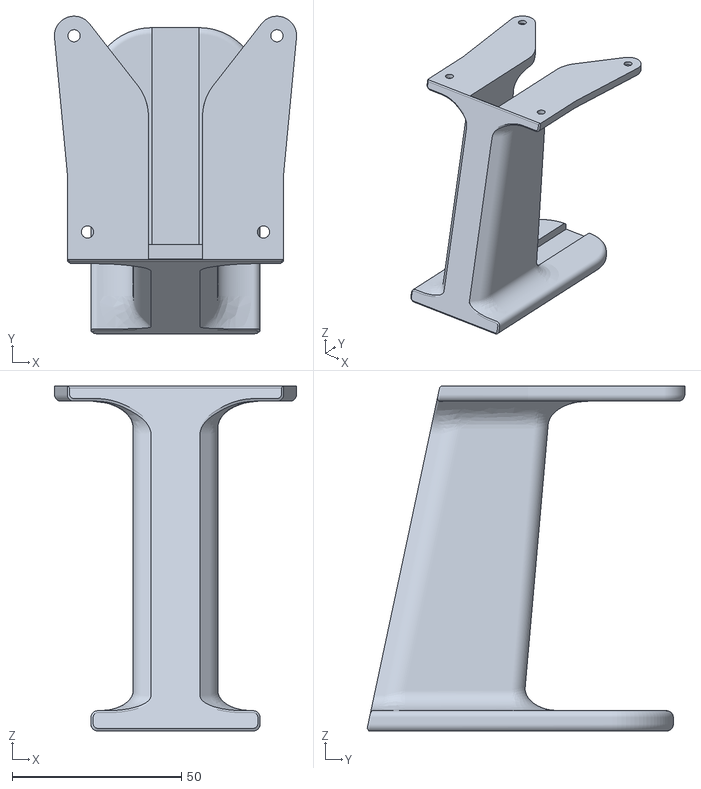
[picture p34: CAD file, 2026-10-28]
cad/out_v3/grip.stl
71.6 x 93.9 x 102.0
