ravikola02/egoumi/sim/assets/meshes/gear_left.stl

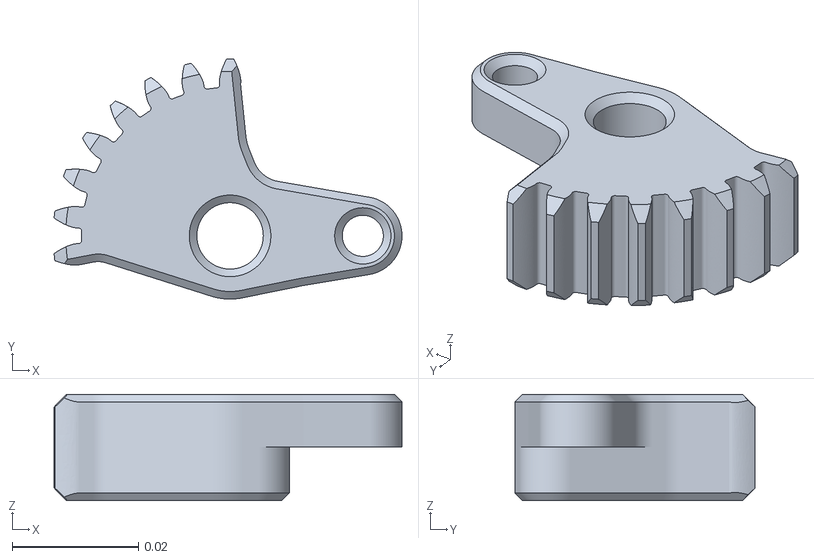
[picture p35: CAD file, 2026-10-28]
sim/assets/meshes/gear_left.stl
0.0551 x 0.038 x 0.0168
