ravikola02/egoumi/cad/out_v3/slider.step

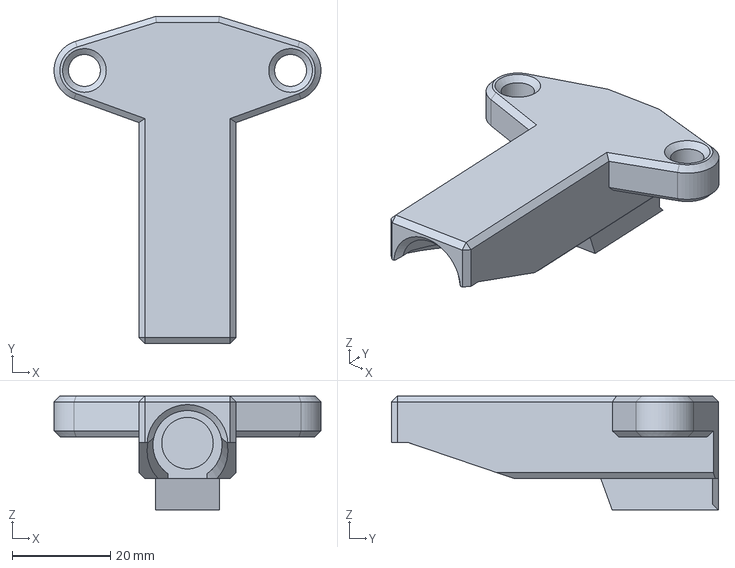
[picture p36: CAD file, 2026-10-28]
cad/out_v3/slider.step
54.4 x 66.6 x 23.2 mm
