ravikola02/egoumi/sim/assets/meshes/finger_holder_right_index.stl

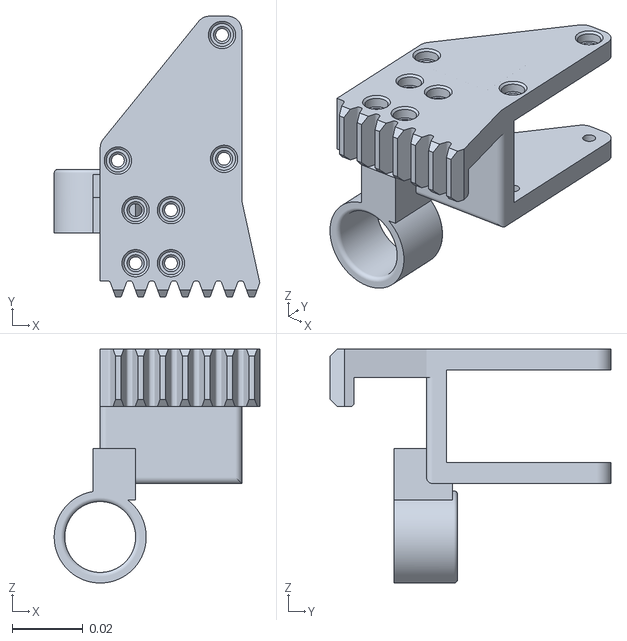
[picture p37: CAD file, 2026-10-28]
sim/assets/meshes/finger_holder_right_index.stl
0.0581 x 0.0793 x 0.0661
