ravikola02/egoumi/cad/out_v3/cube.stl

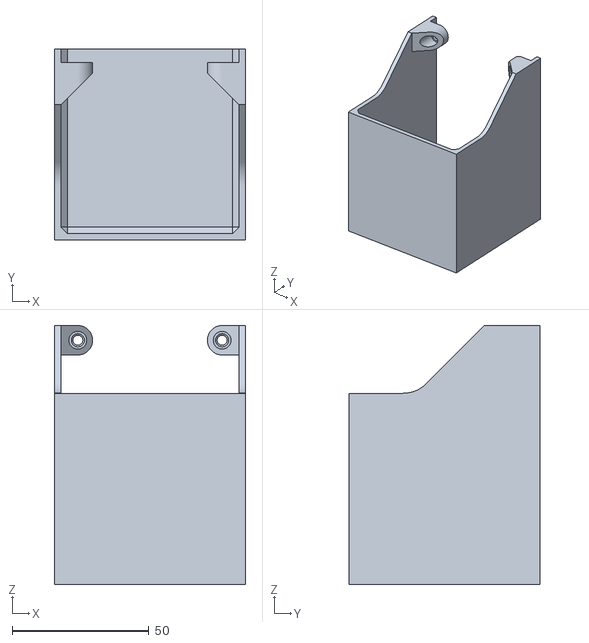
[picture p38: CAD file, 2026-10-28]
cad/out_v3/cube.stl
70.0 x 70.0 x 94.8
