ravikola02/egoumi/sim/assets/meshes/cube.stl

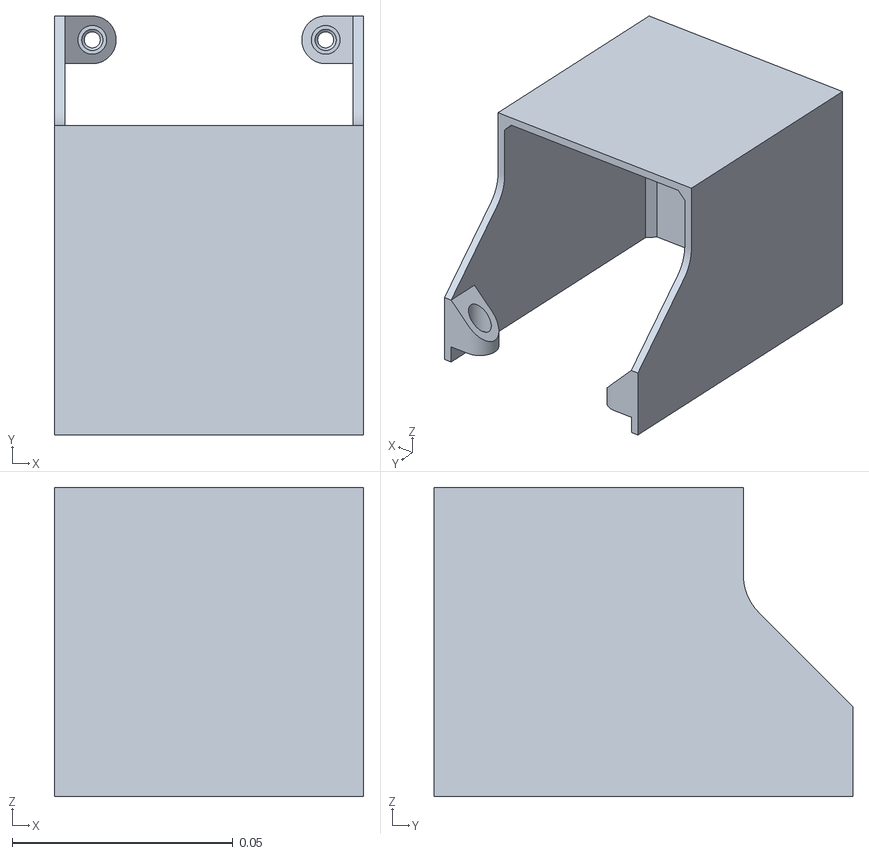
[picture p39: CAD file, 2026-10-28]
sim/assets/meshes/cube.stl
0.07 x 0.0948 x 0.07
