ravikola02/egoumi/sim/assets/meshes/finger_holder_left_thumb.stl

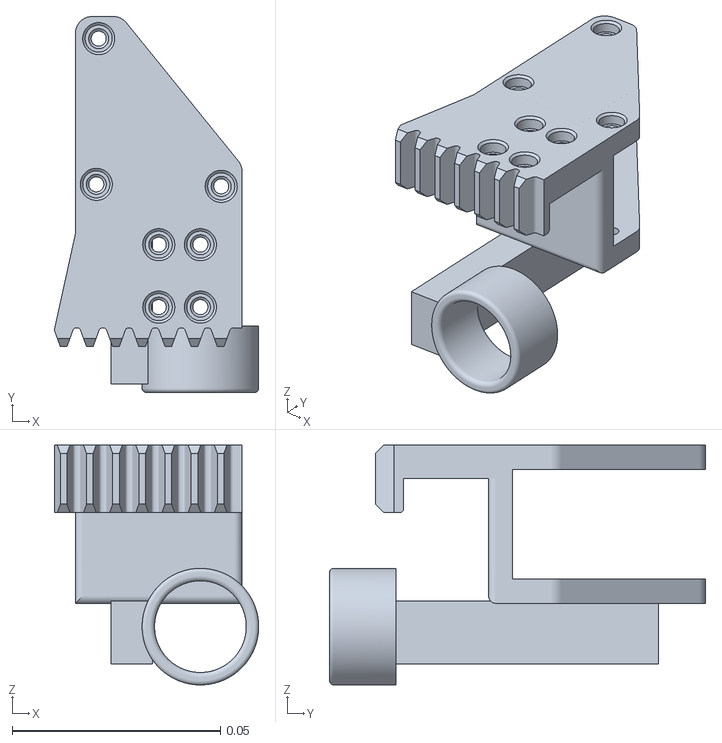
[picture p40: CAD file, 2026-10-28]
sim/assets/meshes/finger_holder_left_thumb.stl
0.0491 x 0.0903 x 0.0576
