ravikola02/egoumi/cad/out_v3/bottom_plate.stl

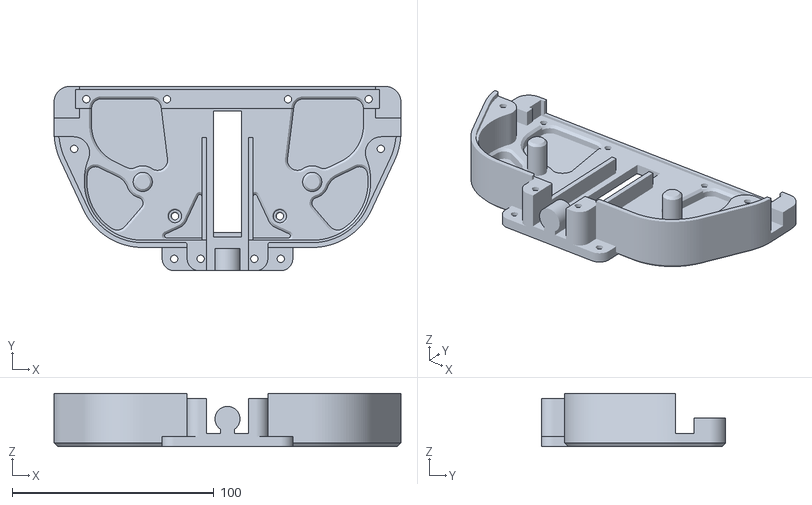
[picture p41: CAD file, 2026-10-28]
cad/out_v3/bottom_plate.stl
172.0 x 91.4 x 26.3
