ravikola02/egoumi/cad/out_v3/finger_holder_right_index.step

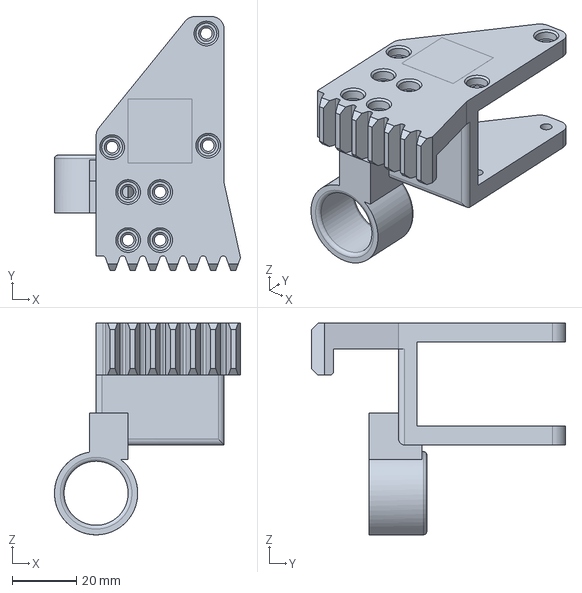
[picture p42: CAD file, 2026-10-28]
cad/out_v3/finger_holder_right_index.step
58.1 x 79.3 x 66.1 mm
