ravikola02/egoumi/sim/assets/meshes/top_cover.stl

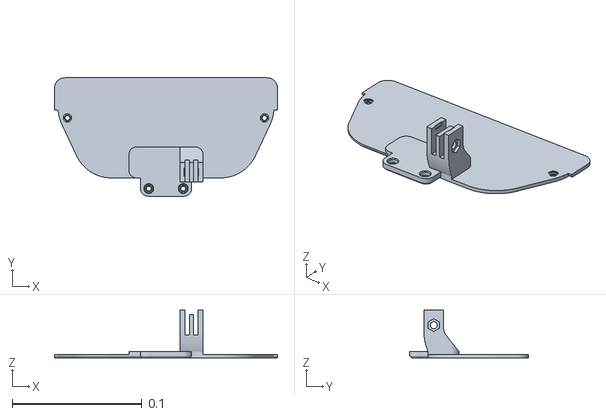
[picture p43: CAD file, 2026-10-28]
sim/assets/meshes/top_cover.stl
0.172 x 0.0914 x 0.0367
