ravikola02/egoumi/cad/out_v3/UMI_print3_fingers_TPU.3mf

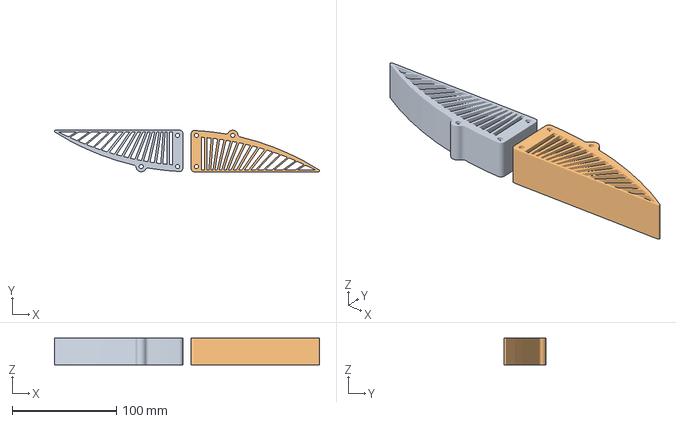
[picture p44: CAD file, 2026-10-28]
cad/out_v3/UMI_print3_fingers_TPU.3mf
254.7 x 40.0 x 25.8 mm
soft_finger_left
soft_finger_right
