ravikola02/egoumi/sim/assets/meshes/slider.stl

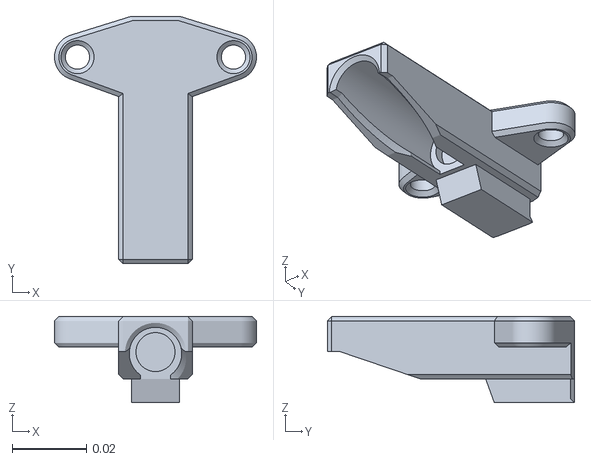
[picture p45: CAD file, 2026-10-28]
sim/assets/meshes/slider.stl
0.0544 x 0.0666 x 0.0232
