ravikola02/egoumi/cad/out_v3/linkage_right.stl

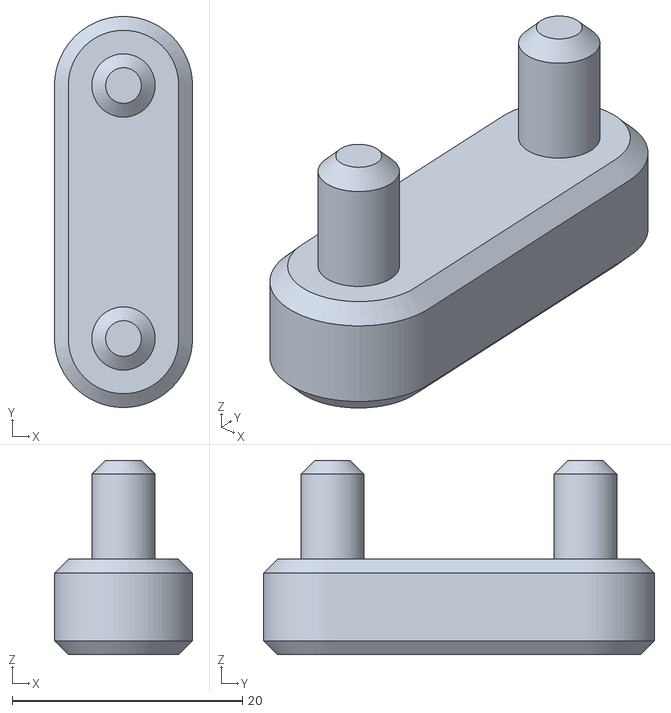
[picture p46: CAD file, 2026-10-28]
cad/out_v3/linkage_right.stl
12.0 x 34.0 x 16.9
