ravikola02/egoumi/cad/out_v3/top_cover.step

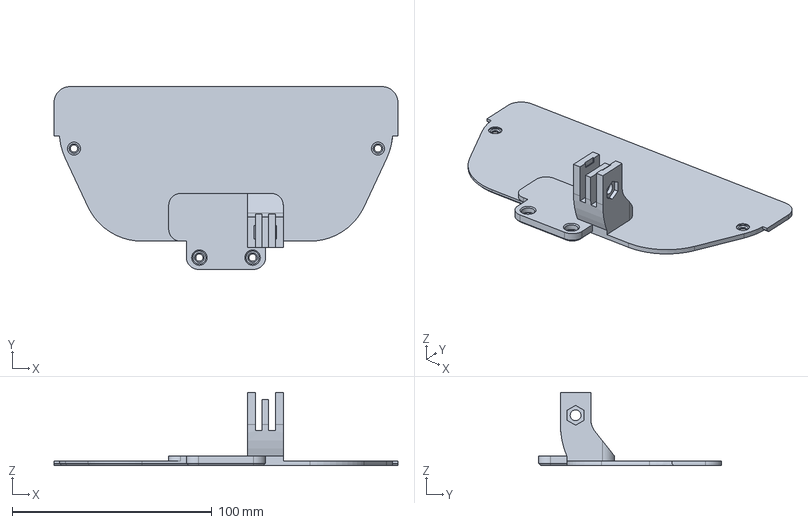
[picture p47: CAD file, 2026-10-28]
cad/out_v3/top_cover.step
172.0 x 91.4 x 36.7 mm
