ravikola02/egoumi/cad/out_v3/finger_holder_left_thumb.step

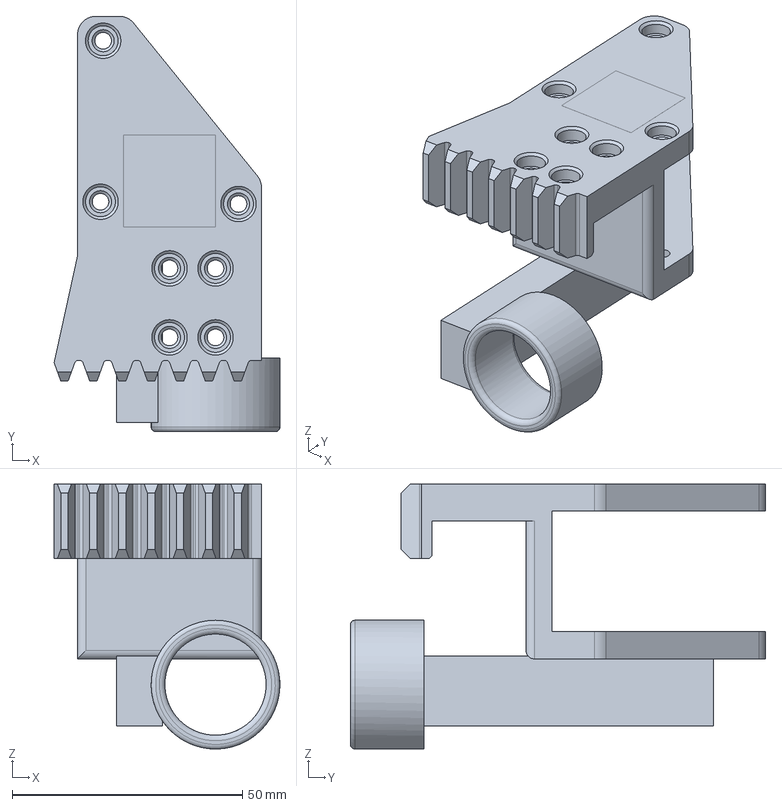
[picture p48: CAD file, 2026-10-28]
cad/out_v3/finger_holder_left_thumb.step
49.1 x 90.3 x 57.6 mm
