ravikola02/egoumi/(list of files, cad)

Other CAD files:
cad/out_v3/soft_finger_left.stl
cad/out_v3/gear_right.stl
sim/assets/meshes/soft_finger_left.stl
sim/assets/meshes/gear_right.stl
cad/out_v3/soft_finger_right.stl
sim/assets/meshes/linkage_left.stl
cad/out_v3/linkage_left.stl
cad/out_v3/finger_holder_left_thumb.stl
cad/out_v3/finger_holder_right_index.stl
cad/out_v3/slider.stl
cad/out_v3/top_cover.stl
