ravikola02/egoumi/assets/print/egoumi_aruco_markers.pdf

## EgoUMI gripper ArUco markers - DICT_4X4_50, IDs 0-7 - FRONT

Print at 100 % (Actual size), double-sided, flip on the LONG edge. Cut along the dashed lines; the white border is part of the sticker (quiet zone) - do not trim it.

ID 0 - 60 mm marker, cut 70 mm - Cube - rear face (faces you) | ID 1 - 60 mm marker, cut 70 mm - Cube - top face
ID 2 - 60 mm marker, cut 70 mm - Cube - left face (thumb side) | ID 3 - 60 mm marker, cut 70 mm - Cube - right face (index side)

ID 4 - 35 mm marker, cut 45 mm - Top cover - left wing (thumb side), where the mirror was

ID 5 - 35 mm marker, cut 45 mm - Top cover - right wing (index side), where the mirror was

ID 6 - 18 mm marker, cut 20 mm -Left finger holder - top pad (thumb side)

ID 7 - 18 mm marker, cut 20 mm -Right finger holder - top pad (index side)

100 mm - if this bar is not exactly 100 mm, reprint at 100 % / Actual size

Generated from configs/gripper_markers.yaml by scripts/make_marker_sheet.py - sizes are the black squares; sticker = marker + white margin

## BACK - where each marker goes (behind its marker when printed double-sided)

Left / right = holding the gripper in your right hand, fingers pointing away from you, GoPro on top. The arrow marks the marker's TOP edge.

TOP EDGE

ID 0

Cube - rear face (faces you) top edge toward the top of the cube

TOP EDGE

ID 1

Cube - top face
top edge toward the fingers (front)

TOP EDGE

ID 2

Cube - left face (thumb side) top edge toward the top of the cube

TOP EDGE

ID 3

Cube - right face (index side) top edge toward the top of the cube

TOP EDGE

ID 4

Top cover - left wing (thumb side), where the mirror was

top edge toward the fingers (front)

TOP EDGE

ID 5

Top cover - right wing (index side), where the mirror was

top edge toward the fingers (front)

TOP EDGE
ID 6

see key

TOP EDGE
ID 7

see key

Placement key

ID 0 (60 mm, cut 70 mm) | Cube - rear face (faces you) | top edge toward the top of the cube
ID 1 (60 mm, cut 70 mm) | Cube - top face | top edge toward the fingers (front)
ID 2 (60 mm, cut 70 mm) | Cube - left face (thumb side) | top edge toward the top of the cube
ID 3 (60 mm, cut 70 mm) | Cube - right face (index side) | top edge toward the top of the cube
ID 4 (35 mm, cut 45 mm) | Top cover - left wing (thumb side), where the mirror was | top edge toward the fingers (front)
ID 5 (35 mm, cut 45 mm) | Top cover - right wing (index side), where the mirror was | top edge toward the fingers (front)
ID 6 (18 mm, cut 20 mm) | Left finger holder - top pad (thumb side) | top edge toward the fingertips
ID 7 (18 mm, cut 20 mm) | Right finger holder - top pad (index side) | top edge toward the fingertips
