ravikola02/egoumi/cad/out_v3/UMI_print1_covers_PLA_plate.png

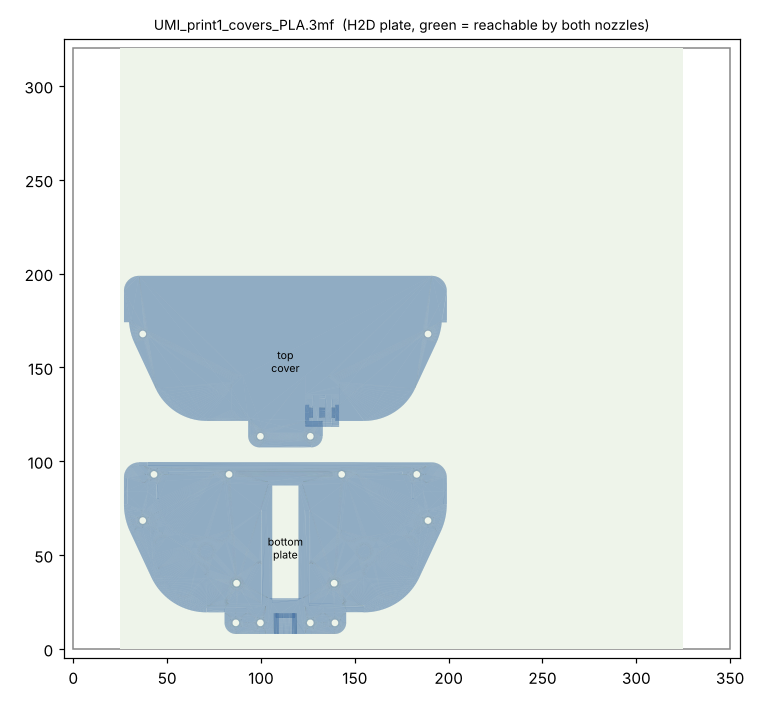
cad/out_v3/UMI_print1_covers_PLA_plate.png
