ravikola02/egoumi/cad/out_v3/UMI_print2_internals_PLA_plate.png

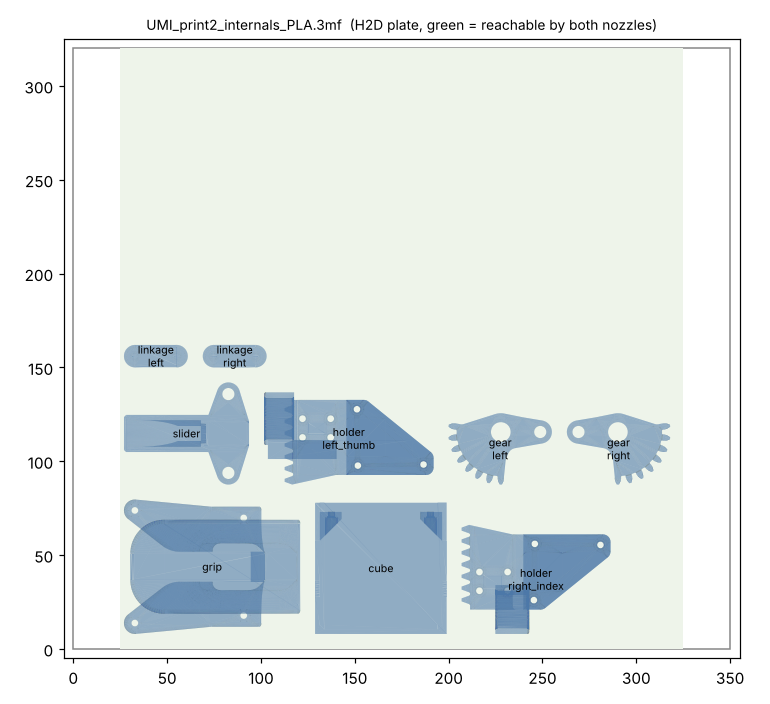
cad/out_v3/UMI_print2_internals_PLA_plate.png
