ravikola02/egoumi/cad/out_v3/UMI_print3_fingers_TPU_plate.png

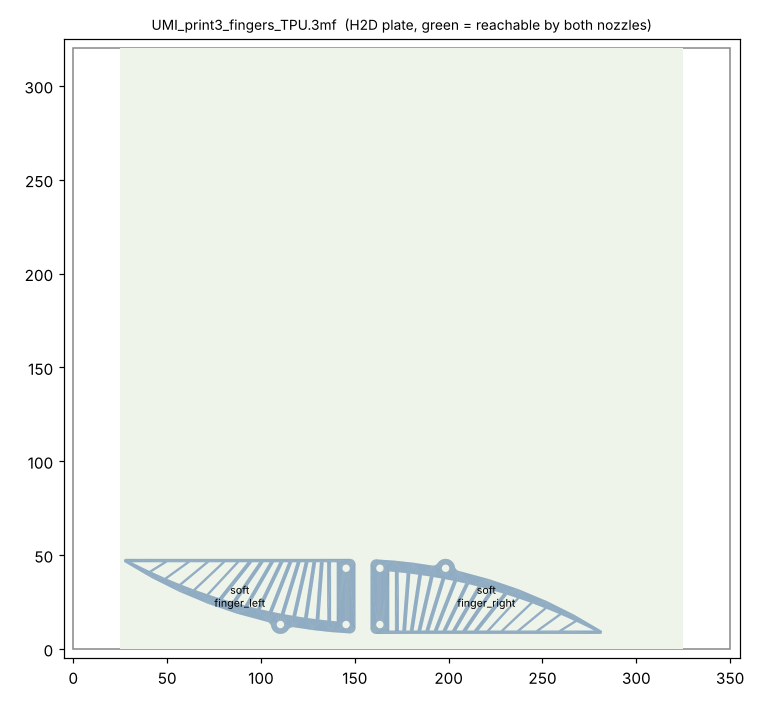
cad/out_v3/UMI_print3_fingers_TPU_plate.png
