ravikola02/egoumi/cad/renders/v3_assembly.png

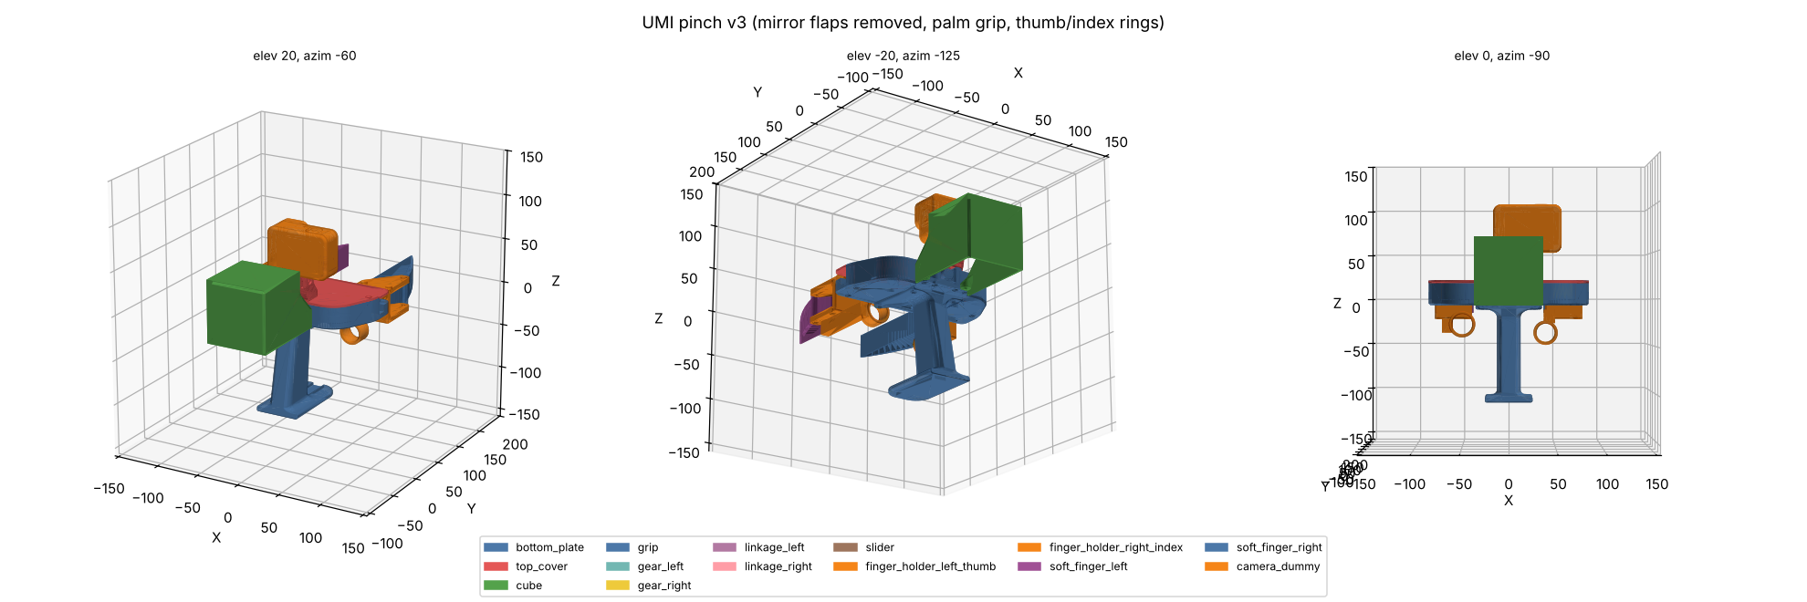
cad/renders/v3_assembly.png
