ravikola02/egoumi/cad/renders/v4_assembly.png

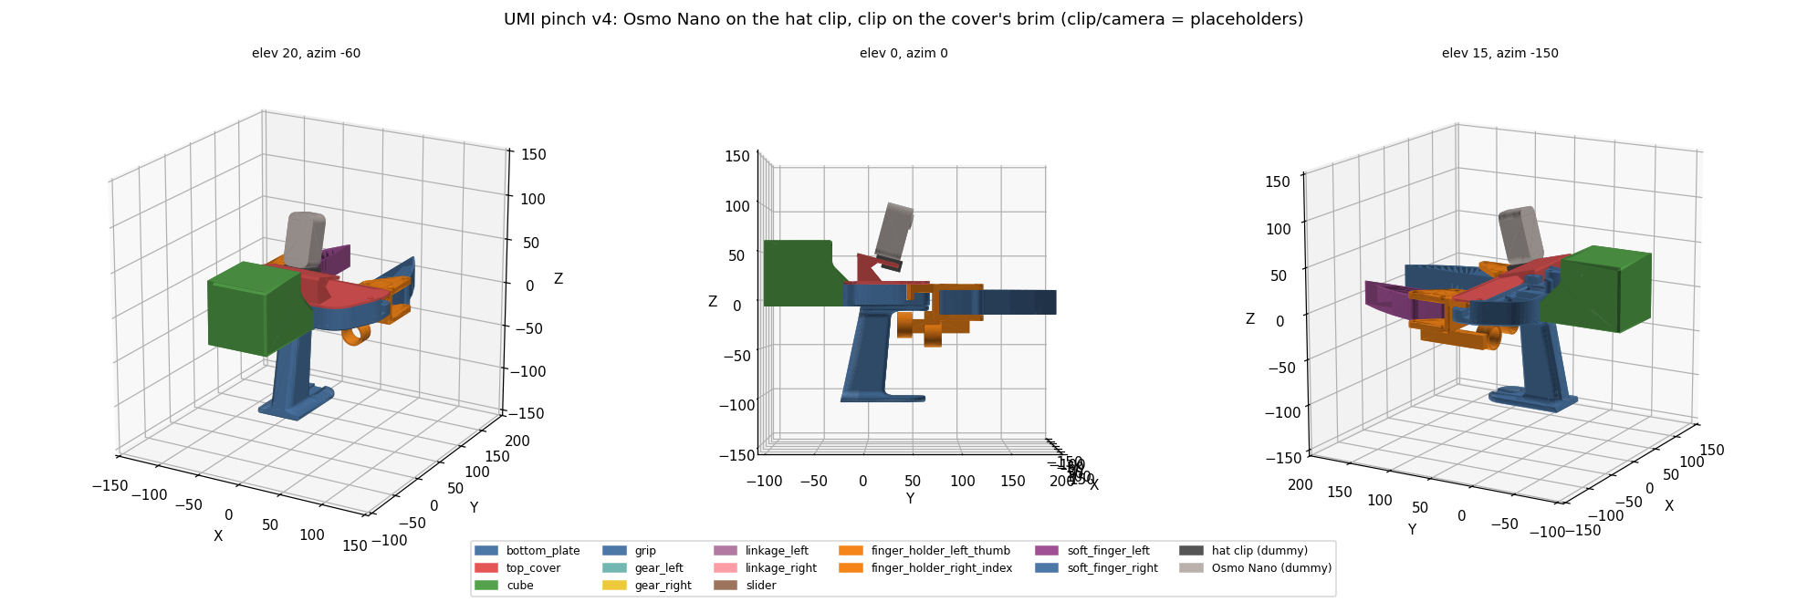
cad/renders/v4_assembly.png
