ravikola02/egoumi/(commit log)

2026-10-28 UMI pinch gripper CAD + ArUco head-camera sim, pose pipeline and preview
    Work in progress, built on h2r_collection: a thumb/index pinch variant of the
    Stanford UMI gripper (CAD and H2D print files, not printed yet), a synthetic
    head-camera renderer with ArUco tags and ground truth, the multi-tag pose and
    jaw-width pipeline, and a HaWoR-style preview video. Tested in sim only.
    Claude-Session: https://claude.ai/code/session_01FkAWs4Q1AoWhnSK5J9cY5U
    [UMI_print1_covers_PLA.3mf, UMI_print2_internals_PLA.3mf, UMI_print3_fingers_TPU.3mf, bottom_plate.stl, camera_dummy.stl, cube.stl, finger_holder_left_thumb.step, finger_holder_left_thumb.stl]
2026-10-28 Add collection/: 3-camera capture -> LeRobot pipeline (h2r_collection flow without HaWoR)
    Sync, browser tagger and clip cutting vendored from h2r_collection 0783627 (MIT,
    same author) with a data-root override; new converter writing LeRobot v3.0 (default)
    or v2.1 from the clips alone. End-effector pose and gripper values are not
    reconstructed yet: datasets are video-only (--state-source none) or carry a flagged
    14-d zero placeholder (--state-source zeros).
    Tested on the h2r_collection Sample session: v3.0 loads in LeRobot 0.4.1; v2.1
    passes the upstream v2.1->v3.0 converter (episodes_stats.jsonl now written).
    Claude-Session: https://c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
2026-10-28 Add pyrender dummy capture + sync/cut checker; fix one-frame cut glitch
    sim/render_capture.py renders a raw 3-camera session for the collection stack:
    head camera, a GoPro on the gripper looking along the fingers, and a blank left
    wrist feed, as independently started recordings with skewed creation_time clocks
    and a shared clap soundtrack. Ground truth goes to <session>/sim_gt/.
    sim/check_capture_sync.py scores the sync offsets and every cut clip (by image
    content) against that ground truth.
    It found a cutter bug inherited from h2r_collection: when a camera's start offset
    was not a whole number of frames, clip frame 0 duplicated frame 1. clip_camera now
    seeks on the camera's own frame grid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
2026-10-28 Trajectories in the collection datasets: aruco + sim_gt state sources, ground-truth columns
    --state-source aruco reconstructs the right gripper TCP from the head clips with
    umi_pipe.pose (head-camera motion from the sim for now; SLAM is not wired) and, with
    --sim-gt, adds observation.state_gt / action_gt to the same dataset. --state-source
    sim_gt writes the ground truth alone. Both use the h2r_collection 14-d layout and
    frame (first head-camera optical frame, eef +z = approach, intrinsic-XYZ rpy). The
    writers take extra per-row float columns.
    On the dummy capture through run_pipeline.py: pose on 100 % of frames, TCP error
    median 0.5-2.2 mm; state_gt equals the independent sim_gt build; acti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
2026-10-28 Overhead-right head view for jaw tags, two renderer fixes, h2r EMA on predicted state
    Head camera (render only; gripper and markers unchanged): default is now the
    overhead-right view (0.18, 0.10, 0.74) -> (0, 0.10, 0.08), picked from a sweep of 25
    placements. pick_place: jaw width measured on 95 % of frames (was 21 % from the
    original view), TCP error median 0.41 mm, max 1.8 mm, no single-tag frames.
    --head/--look keep the original view available in both renderers.
    Renderer fixes: tag textures are uploaded as RGBA (RGB rows that were not a multiple
    of 4 bytes, e.g. the 266 px jaw tags, rendered sheared), and sticker quads now have
    outward normals (they were lit by ambient light only). The e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
2026-10-28 Restore egocentric head view; jaw width from the gripper camera; EMA chosen by criterion
    Corrects 13b299f, which moved the HEAD camera overhead; the request was about the
    wrist (gripper GoPro) camera. The head view is back to the egocentric default
    (0, -0.42, 0.58) -> (0, 0.12, 0) in both renderers, and docs/numbers/media are
    back on that view (re-measured with the renderer fixes, which stay).
    Gripper camera: render_capture.py pitches it 15 deg down at the GoPro lens
    (--wrist-tilt); at 0 deg both jaw tags fall just outside its 120 deg pinhole frame,
    from 5 deg they are detected at every travel. --state-source aruco now measures
    jaw width from that feed (camera rigid to the body, 1-D fit per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
2026-10-28 EEF frame in the h2r_collection convention; no table marker, wood-grain table
    Dataset orientation now uses h2r_collection's hand frame mapped onto the gripper,
    the standard parallel-gripper EEF: +z approach (body +Y), +y jaw axis toward the
    thumb-side jaw (body -X), +x grip-plane normal (body -Z); intrinsic-XYZ rpy. It is
    identical to h2r's _wrist_rotmats applied to the fingertip points (0.0000 deg over
    every row); the finger axis is used as z rather than h2r's wrist->pinch line,
    which a wrist below the grip would tilt ~23 deg. No rpy wraps in the sim capture.
    Sim scene: the ArUco table tag is no longer rendered (nothing uses it: the world
    frame is each episode's first head-camera frame); S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
2026-10-28 Presentable README preview: recording vs reconstruction; UMI attribution up front
    preview_gripper.py: --style presentation shows the raw egocentric recording (REC
    light, timecode) next to the 3D reconstruction, with title bars, a legend and
    labels. Both styles now auto-frame the world view on the gripper track plus the
    head-camera path (seen from the side), draw the recording camera as a small model
    with a larger frustum and its path, and keep the debug style as the default.
    render_episode.py uses the room-grey background (no black wedge past the wall).
    README: the main preview is the presentation video with a caption naming both
    panels, and states at the top that the gripper design is adap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
2026-10-29 EMA on the predicted orientation too, filtered on SO(3)
    --state-source aruco now also smooths orientation: a causal EMA on rotations
    (R_f[t] = R_f[t-1] exp(alpha log(R_f[t-1]^T R[t])), i.e. geodesic slerp toward each
    new rotation) applied before conversion to Euler angles, so the +-pi wrap cannot
    break it (through 180 deg yaw the largest step stays 1.0 deg; component-wise Euler
    smoothing jumps 63.8 deg). --ema-rot defaults to --ema-pos (0.18), so the whole
    pose carries one 152 ms lag; on a single axis it equals the scalar EMA to 1e-14 deg.
    Sim capture: one-step orientation delta noise 0.76 -> 0.11 deg, worst-case noise
    4.0 -> 1.6 deg, at 2.9 deg median lag error vs raw ground truth. Ground-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
2026-10-29 Printable ArUco marker sheet with matching back-side placement labels
    scripts/make_marker_sheet.py builds assets/print/egoumi_aruco_markers.pdf from
    configs/gripper_markers.yaml: all eight markers (DICT_4X4_50, IDs 0-7) at exact size
    as vector modules inside their white margins, dashed cut lines, captions, a 100 mm
    scale bar and registration crosses; page 2 is mirrored for long-edge duplex
    (--flip short for the other binding) so each label - ID, part and face, and an
    arrow on the marker's top edge - prints directly behind its marker, plus a
    placement key. The config gains place/top text per tag (ignored by the pipeline).
    Checked on a 600 dpi raster: all IDs detected, every marker upright, b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
2026-10-29 h2r_collection camera setup (DJI Osmo Nano) and recording guide
    configs/cameras_osmo_nano.yaml: the cameras and intrinsics h2r_collection used -
    DJI Osmo Nano on head and wrist, HaWoR focal 600 px at 1920 wide, principal point
    at the centre, no distortion model; nominal gripper-camera mount (GoPro-mount lens
    position, 15 deg down). Default --camera for --state-source aruco.
    Real-footage fixes in the aruco source: intrinsics are rescaled to each clip's
    resolution (4K head -> 1200 px), and each dataset row takes the frame nearest its
    timestamp at the clip's own rate (59.94 fps head vs 30 fps rows; frame k is not
    row k). --fps auto now uses the slowest camera rounded to an integer (Osmo Nano
    2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
    [cameras_osmo_nano.yaml]
2026-10-29 collection README: dataset numbers with the Osmo Nano cameras
    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
2026-10-29 HaWoR SLAM in the main pipeline: head-camera motion for --state-source aruco
    collection/head_slam.py (HaWoR env) writes the head frames at the dataset-row
    timestamps into HaWoR's layout, masks the gripper CAD + a hand/forearm stand-in at
    each row's ArUco pose (dilated 25 px), calls hawor_slam() unchanged (masked
    DROID-SLAM + Metric3D scale, as h2r_collection) and caches one camera pose per row.
    --cam-motion hawor_slam is the default (sim_gt / none remain); HAWOR_REPO /
    HAWOR_PYTHON point at the h2r_collection HaWoR checkout and env.
    Sim rooms are textured now (tiled floor, plaster walls with posters): in the plain
    room SLAM failed (Metric3D scale 3.9x off, 13 mm/frame jitter). Rendered capt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
2026-10-29 CAD v4 preview: Osmo Nano hat-clip bracket in place of the GoPro mount
    cad/build_v4.py: v3 with the top cover's GoPro mount replaced by an inverted-L
    bracket for the DJI Osmo Nano magnetic hat clip; the brim droops 15 deg so the
    camera looks down at the jaws (the pitch validated in the sim). Preview renders in
    cad/renders/v4_*.png; no print files yet. .gitignore: local tmp_print/.
    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
2026-11-02 scaled_K: keep square pixels when a clip's aspect differs from the camera entry (Osmo Nano 4:3 head)
    A 1920x1440 head clip against the 1920x1080 entry gave fy = 800; now f scales with the width and the
    principal point stays at the centre (16:9 taken as a vertical crop of the 4:3 sensor; unverified).
    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
2026-11-02 gripper_minmax: wrist-camera gripper value by min/max normalisation of the jaw-tag image path
    First real capture (first_test): the mount-based jaw fit read every frame as wider than open (gripper 0) because
    the real wrist camera mount and lens differ from the nominal config (joint fit: ~25 deg pitch, ~770 px effective
    focal, strong distortion). This rewrites observation.state/action[:, 13] of an existing dataset from the jaw
    tags' pixel paths, normalised to the session's (or a calibration clip's) open/closed extremes.
    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
2026-11-02 preview_gripper: --ego adds a chase view behind the head camera next to the side view
    Third panel follows the head camera from --ego-back / --ego-up (EMA-smoothed, --ego-smooth), looking along its line
    of sight; the head camera's own box and frustum are hidden there. Needs a z-up world (sim, or a levelled real
    sequence). Default two-panel output unchanged.
    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
2026-11-02 preview_gripper --ego: small head camera + short frustum at the end of its path in the chase view
    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
2026-11-02 Previews: drop the body-tags plot, sim preview from the 3-camera capture (gripper-camera width, HaWoR SLAM)
    The README sim preview came from a head-only episode, so its jaw width existed only where the head camera saw a
    jaw tag (~10 %). scripts/episode_preview.py builds a preview sequence from any collection episode (real or rendered
    capture): head frames, gripper_pose, the converter's SLAM, the dataset's gripper value, sim ground truth when
    given; real episodes are levelled for display. Timeline is now TCP error (or reprojection RMS) + jaw width.
    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
2026-11-02 Out of WIP; real preview: TCP xyz plot, hub and box placed from the gripper
    - README / collection README: no WIP banner; known limitations section (calibration, nominal gripper-camera mount,
    min/max gripper value on real captures, non-gravity world); real capture no longer called 'first'
    - preview timeline without ground truth: TCP x, y, z instead of the body reprojection RMS
    - episode_preview --grasped-mesh / --container-mesh: object meshes placed from the gripper (grasp, carry, release);
    preview_gripper renders <seq>/objects.npz. Meshes are read from a local path and not part of the repo.
    Claude-Session: https://claude.ai/code/se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
2026-11-02 Call the head-camera SLAM masked DROID-SLAM; credit HaWoR's wrapper in the docs
    --cam-motion droid_slam is the new default name (hawor_slam still accepted, same behaviour; SLAM caches unchanged).
    Docs and dataset info say 'masked DROID-SLAM + Metric3D scale'; README credits note that the approach comes from
    HaWoR and that collection/head_slam.py runs HaWoR's SLAM wrapper unmodified from a local checkout (CC BY-NC-ND,
    not redistributed), plus DROID-SLAM and Metric3D.
    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
2026-11-02 Gripper EMA: same alpha as the pose by default (0.18), in the converter and gripper_minmax
    --ema-grip now defaults to --ema-pos (was 1.0 = off), so state and gripper carry one lag; gripper_minmax.py gets
    --ema (default 0.18) and records it in info.json. 1.0 turns either off.
    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
2026-11-03 aruco state source: drop single-frame pose flips before gap filling and EMA
    kitting_umi review: four episodes had one-frame 130-155 mm / ~25 deg pose flips (planar / single-tag PnP
    ambiguity) that the EMA left as 6-7 cm blips. reject_spikes() drops a measured pose that disagrees with the
    median of its +-3 measured neighbours by > 50 mm or > 20 deg (6 of 21,737 frames on that session); the count is
    reported per episode as pose_spikes_rejected.
    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
